R-Mutura/BIM_BOARD/Images/BIM_PCB 1.png

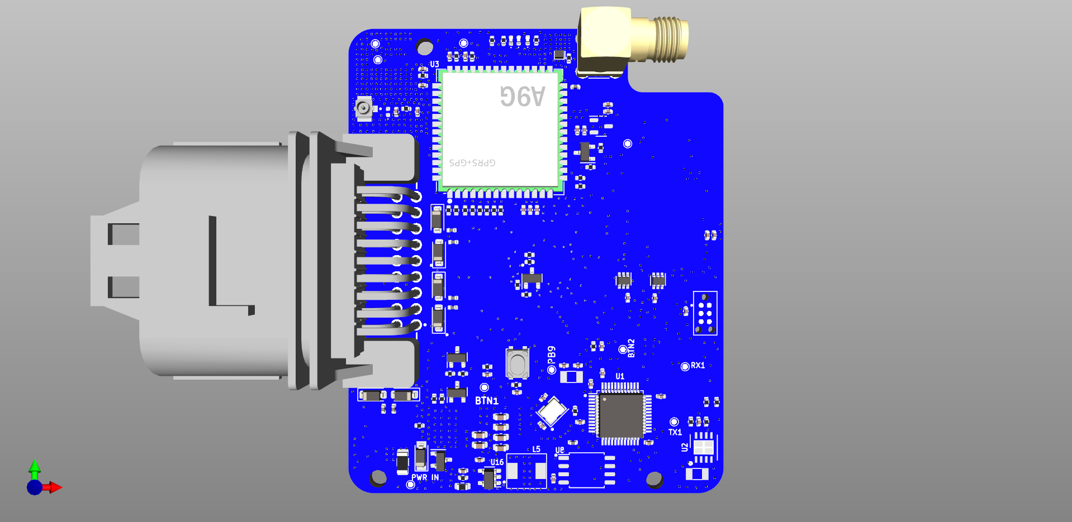
Images/BIM_PCB 1.png
