R-Mutura/BIM_BOARD/Images/BIM_PCB 3.png

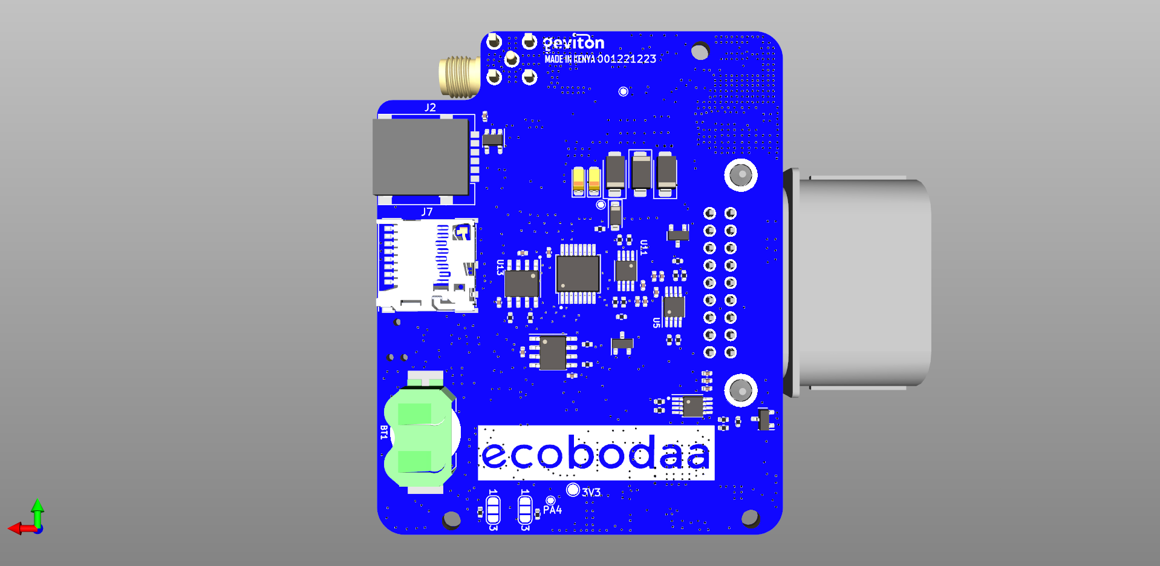
Images/BIM_PCB 3.png
