R-Mutura/BIM_BOARD/ASSETS/BIM_PCB_V2/connector description.txt

COMM:
- A
- B
- GND
- 5V

DISPLAY
- 3V3
- DI
- SCK
- DC
- CS
- RST
- Backlight
- BUZZER
- BUTTON
- GND

PROGRAM
- SWD
- SCK
- SWO
- GND
- RESET
