R-Mutura/BIM_BOARD/ASSETS/BIM_PCB_V2/Connectors.png

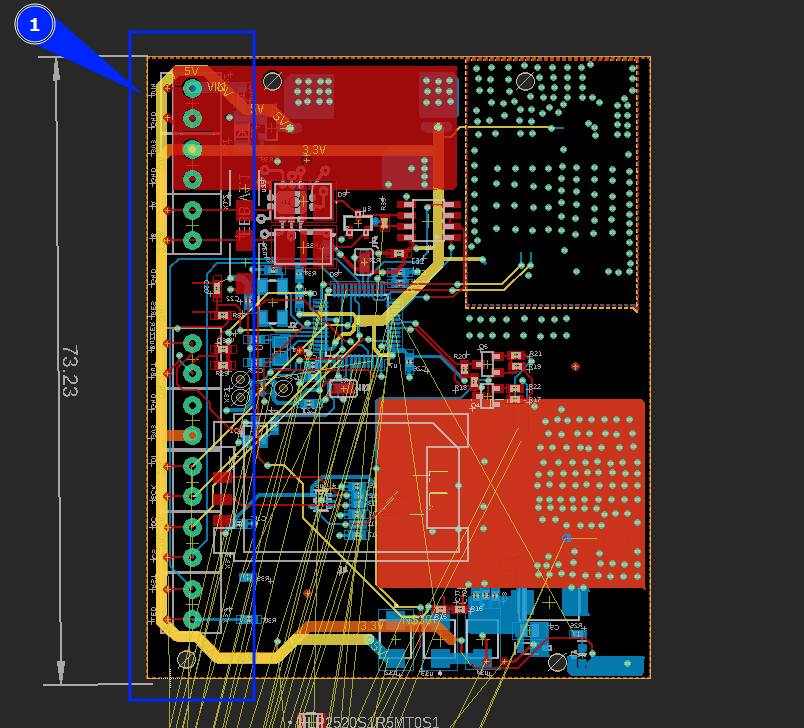
ASSETS/BIM_PCB_V2/Connectors.png
