R-Mutura/BIM_BOARD/Images/BIM_PCB 5.png

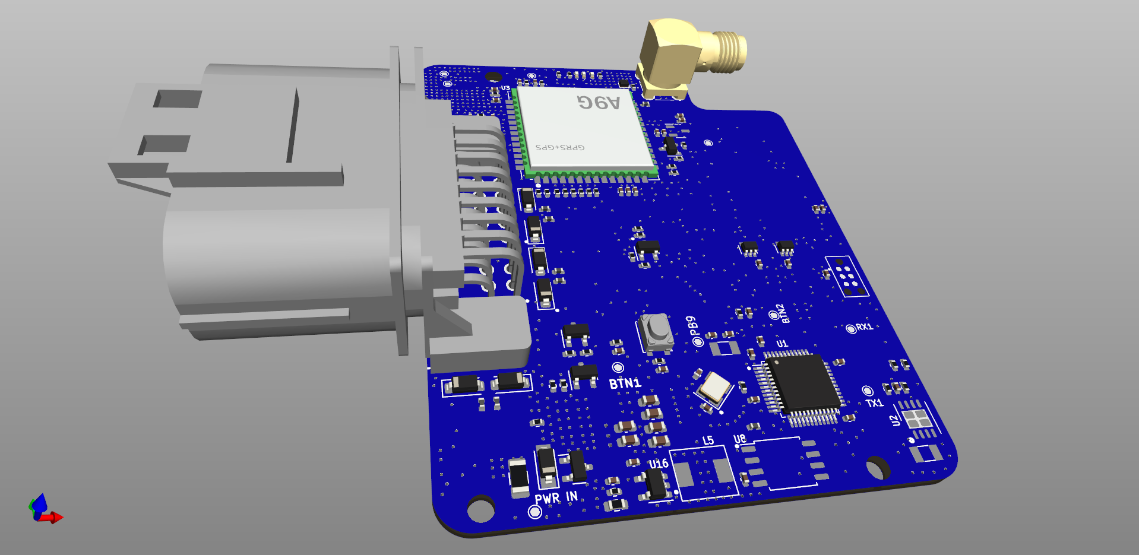
Images/BIM_PCB 5.png
