R-Mutura/BIM_BOARD/ASSETS/BIM_V2.DXF

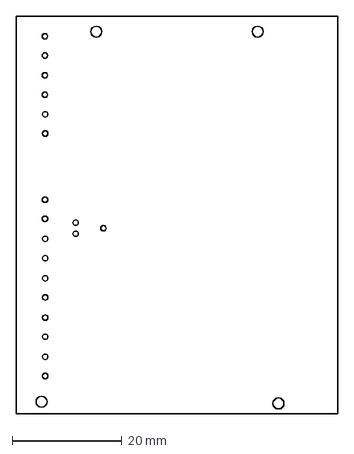
[picture p5: CAD file, 2023-12-07]
ASSETS/BIM_V2.DXF
58.6 x 72.5 mm
