R-Mutura/BIM_BOARD/SCH_PDF/BIM_PCB.pdf

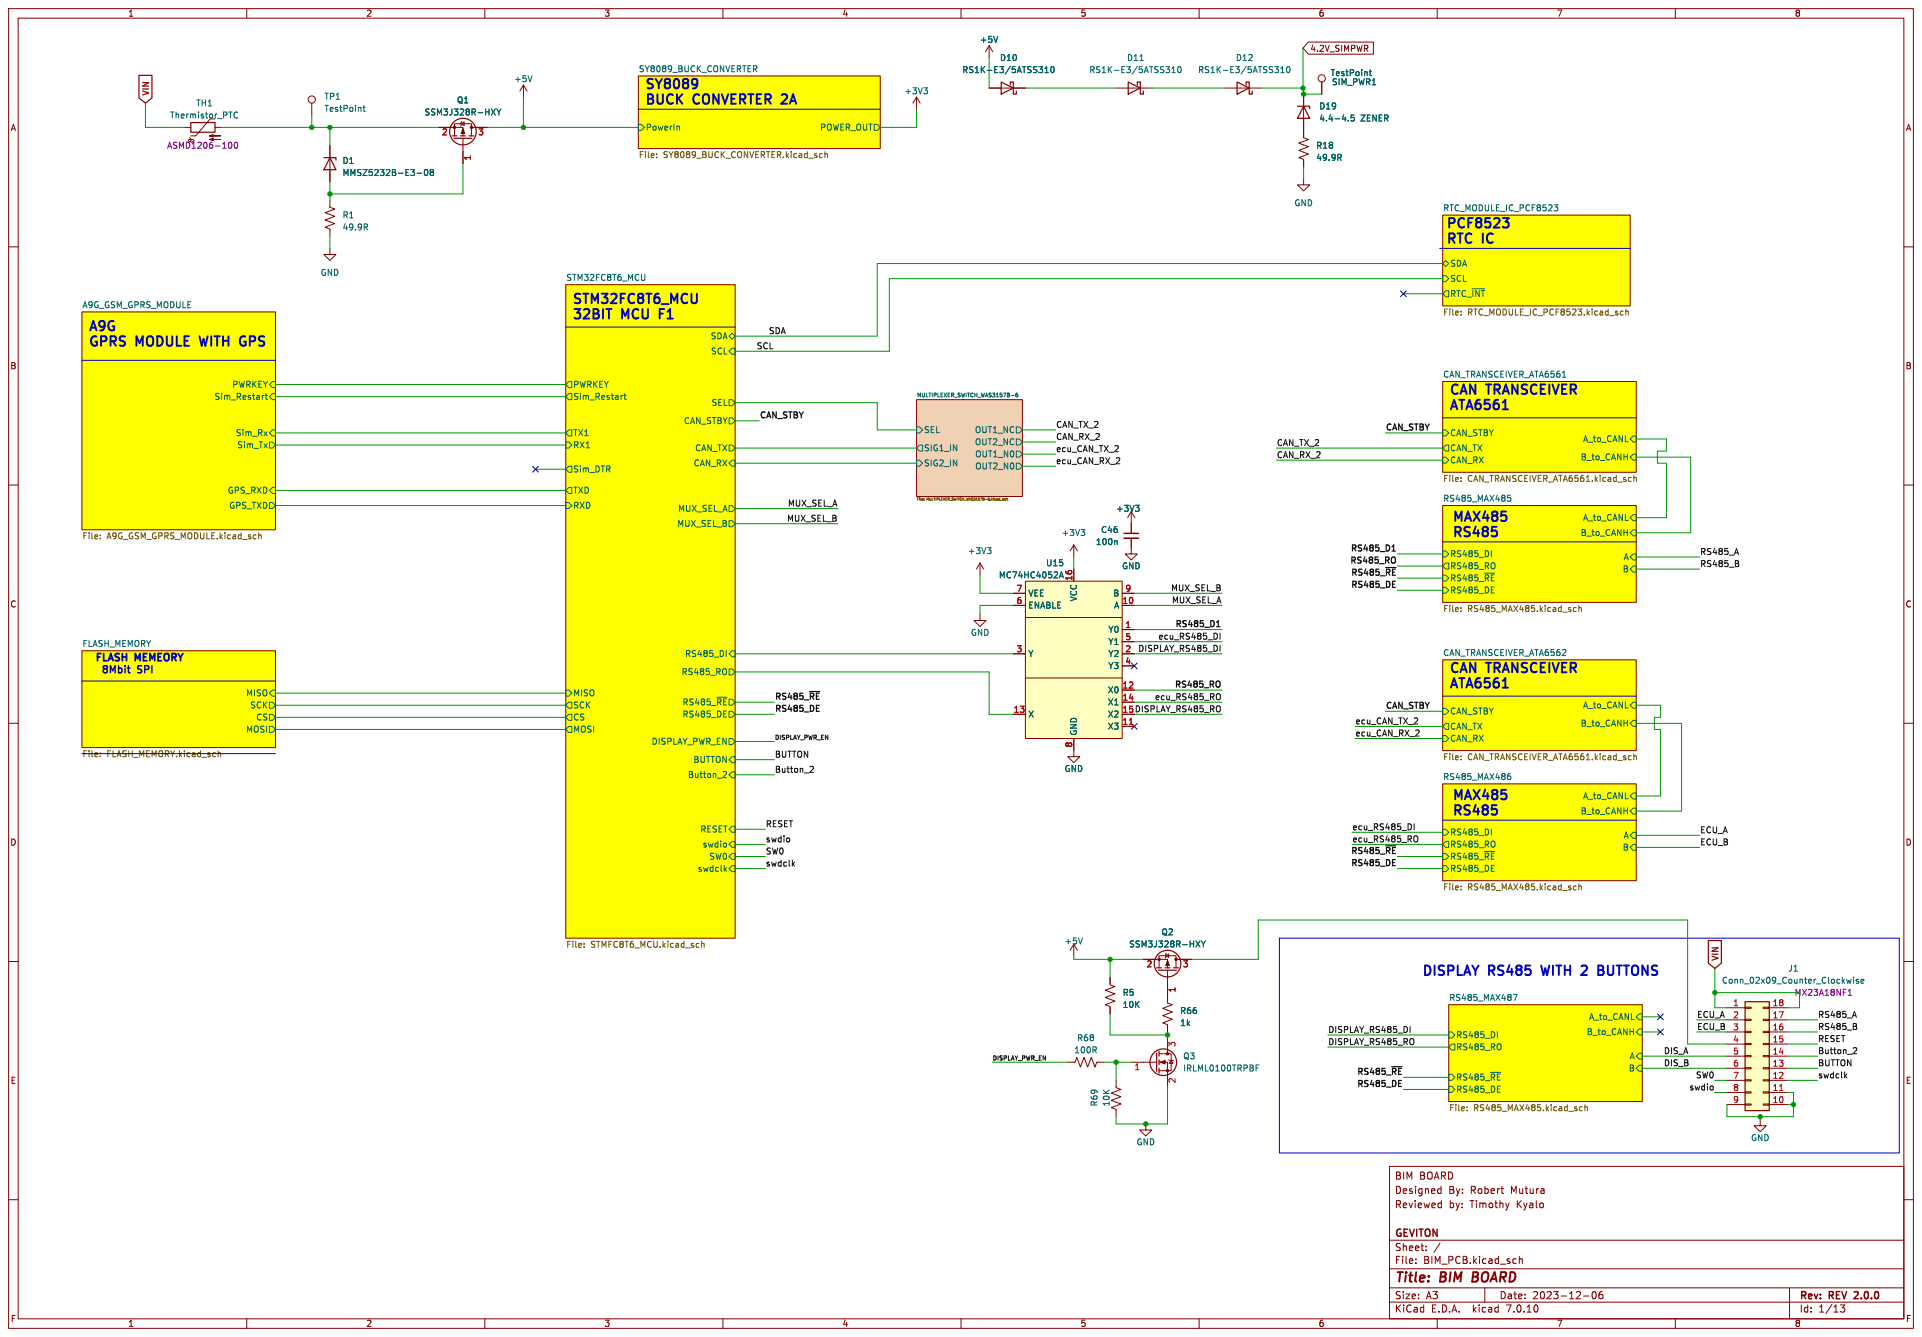
[picture p6: page 1]

Id: 1/13 Title: BIM BOARD

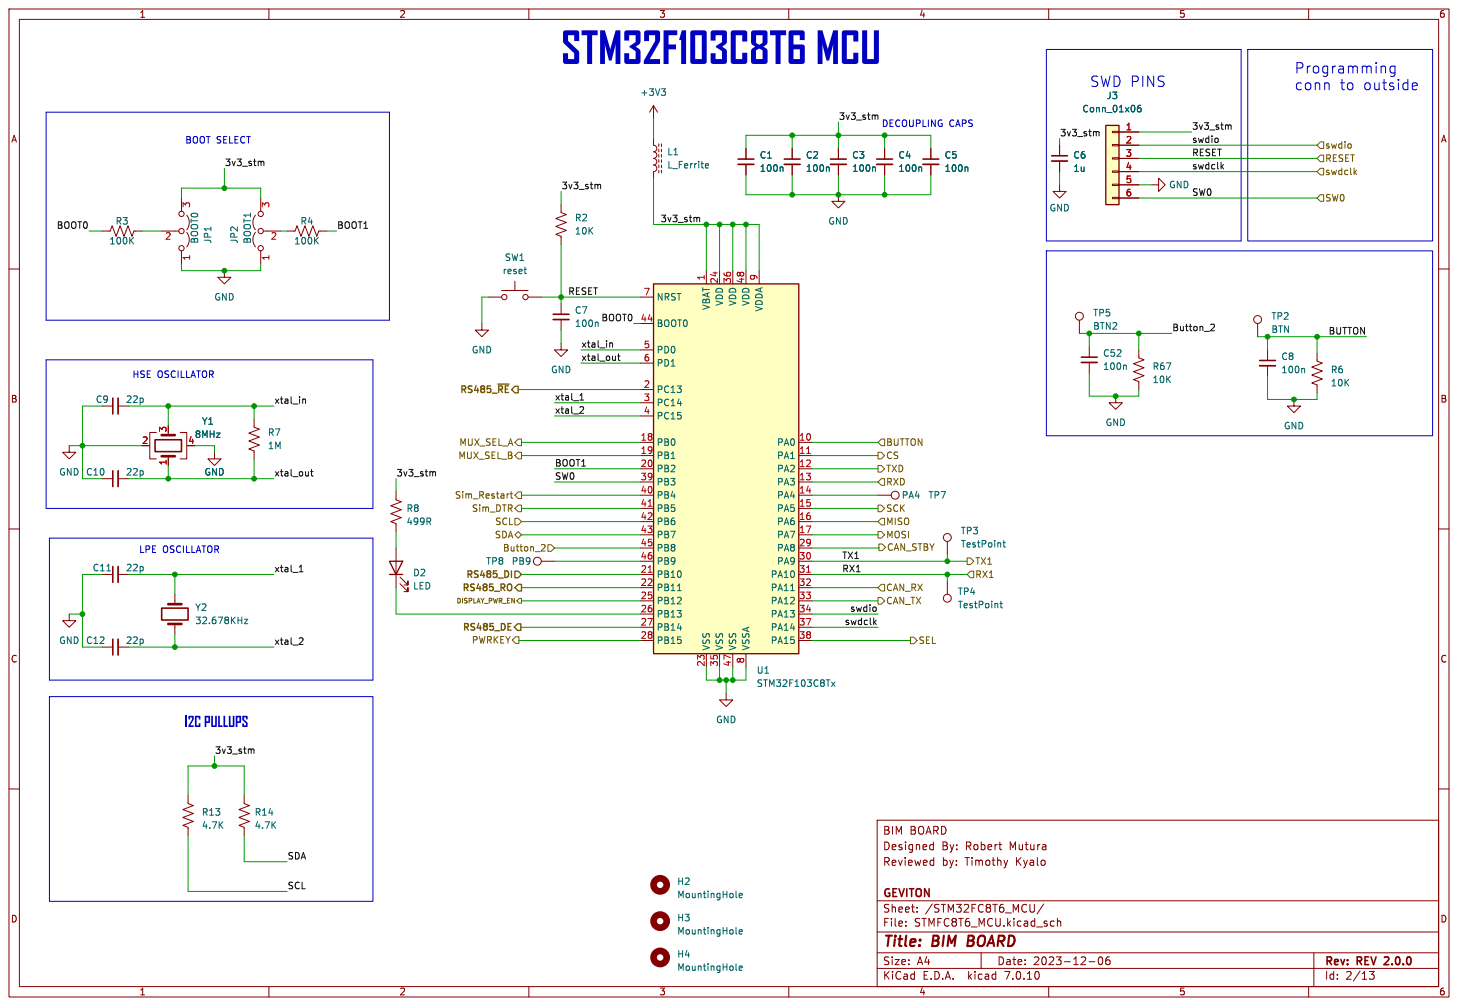
[picture p7: page 2]

DECOUPLING CAPS HSE OSCILLATOR

1 PA0 10 PA1 11 PA2 12 PA3 13 PA4 14 PA5 15 PA6 16 PA7 17 PB0 18 PB1 19 PC13 2 PB2 20 PB10 21 PB11 22 VSS 23 VDD 24 PB12 25 PB13 26 PB14 27 PB15 28 PA8 29 PC14 3 PA9 30 PA10 31 PA11 32 PA12 33 PA13 34 VSS 35 VDD 36 PA14 37 PA15 38 PB3 39 PC15 4 PB4 40 PB5 41 PB6 42 PB7 43 BOOT0 44 PB8 45 PB9 46 VSS 47 VDD 48 PD0 5 PD1 6 NRST 7 VSSA

Id: 2/13 Title: BIM BOARD

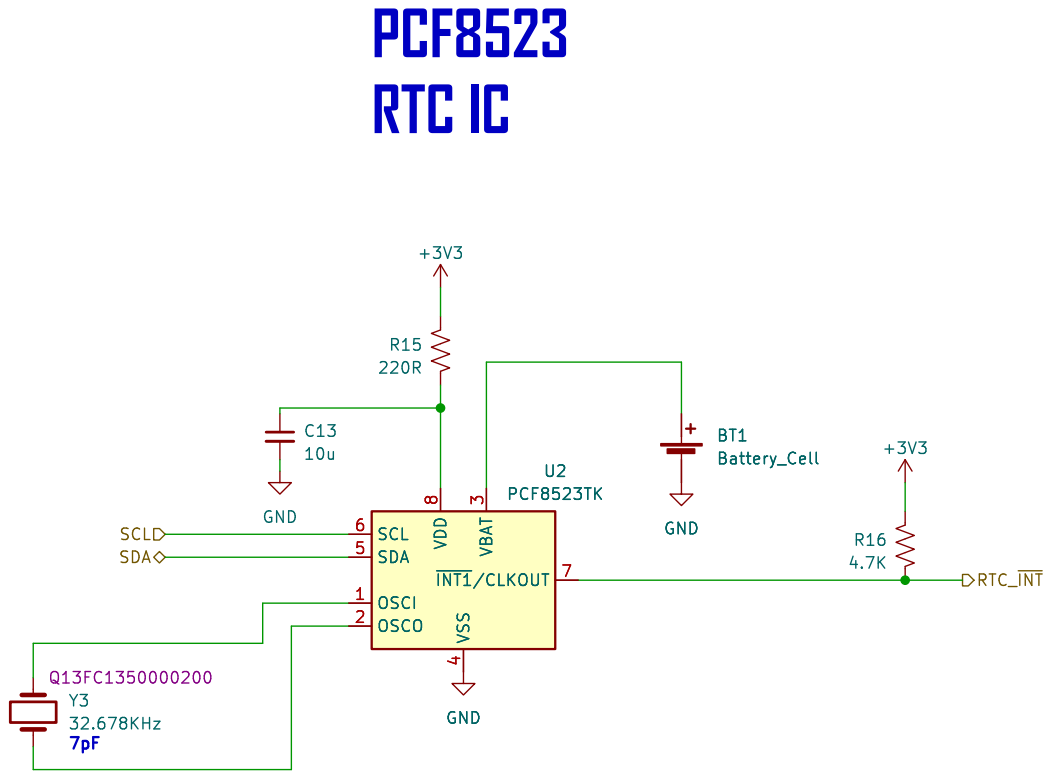
[picture p8: page 3]

Id: 3/13 Title: BIM BOARD

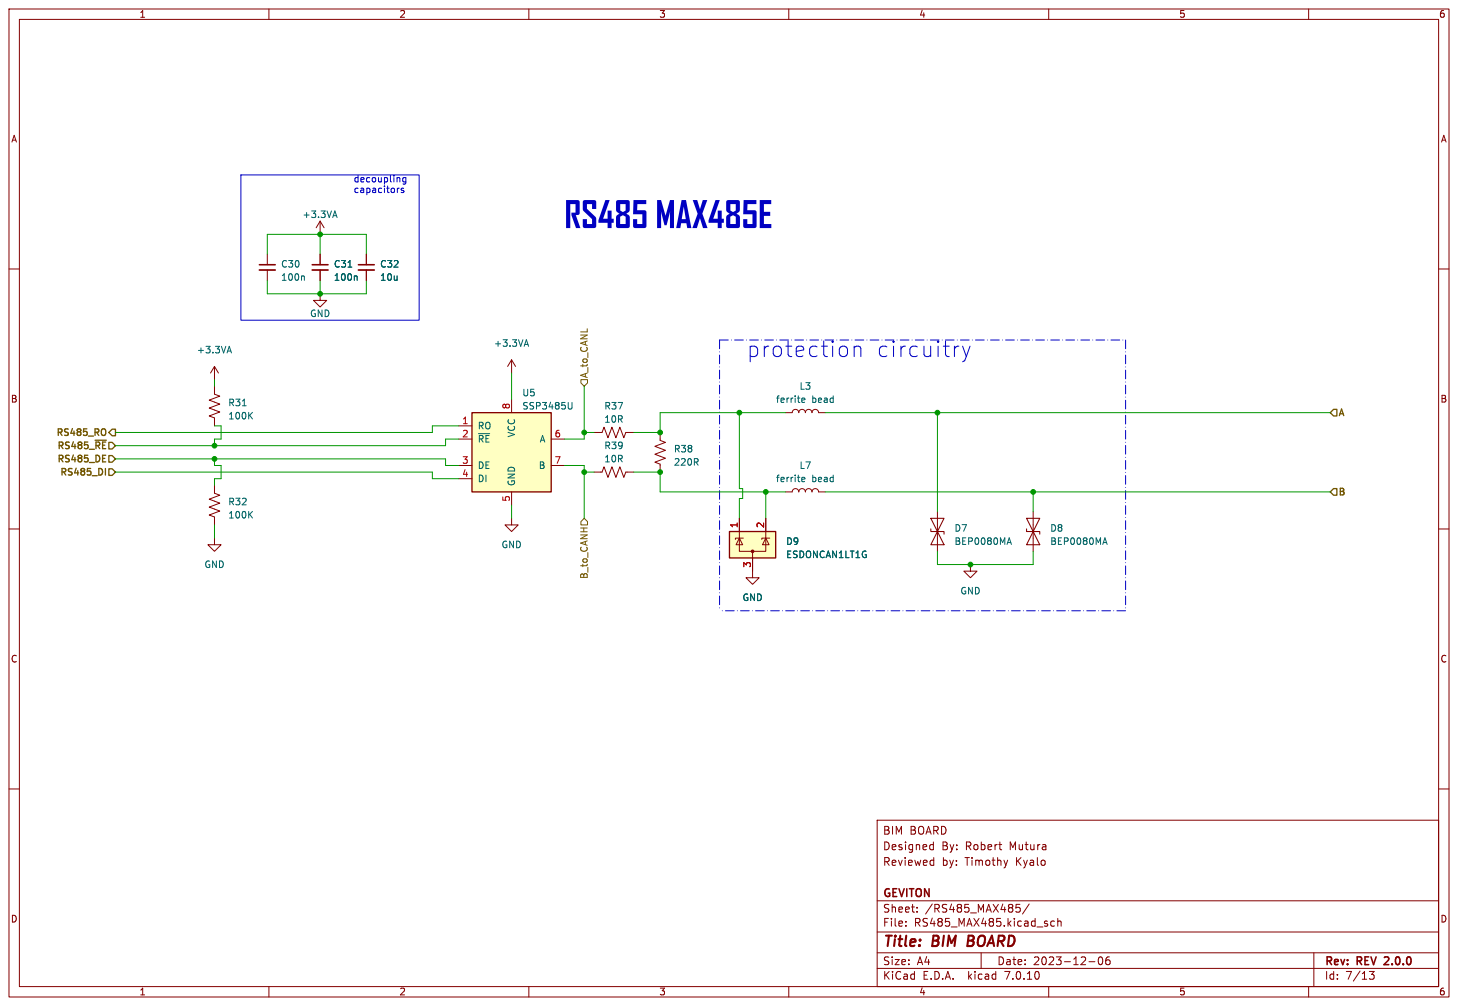
[picture p9: page 4]

Id: 7/13 Title: BIM BOARD

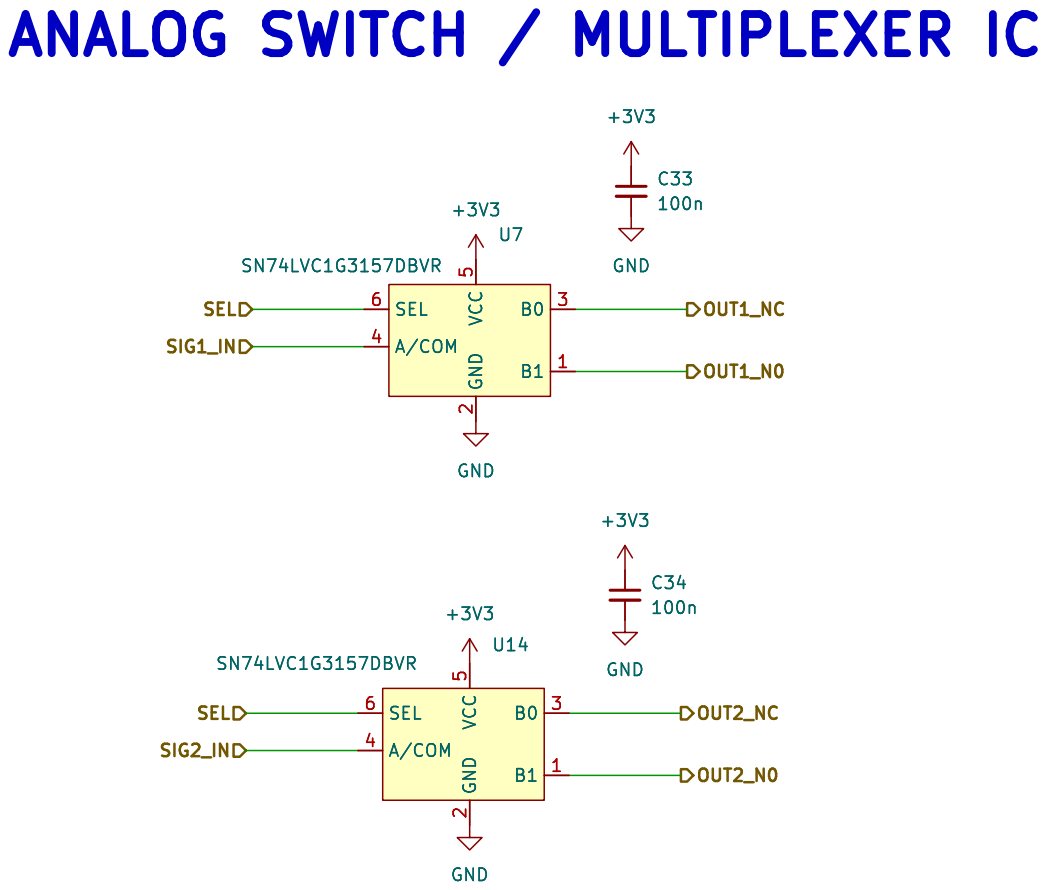
[picture p10: page 5]

Id: 8/13 Title: File: MULTIPLEXER_SWITCH_WAS3157B-6.kicad_sch Sheet: /MULTIPLEXER_SWITCH_WAS3157B-6/ GND

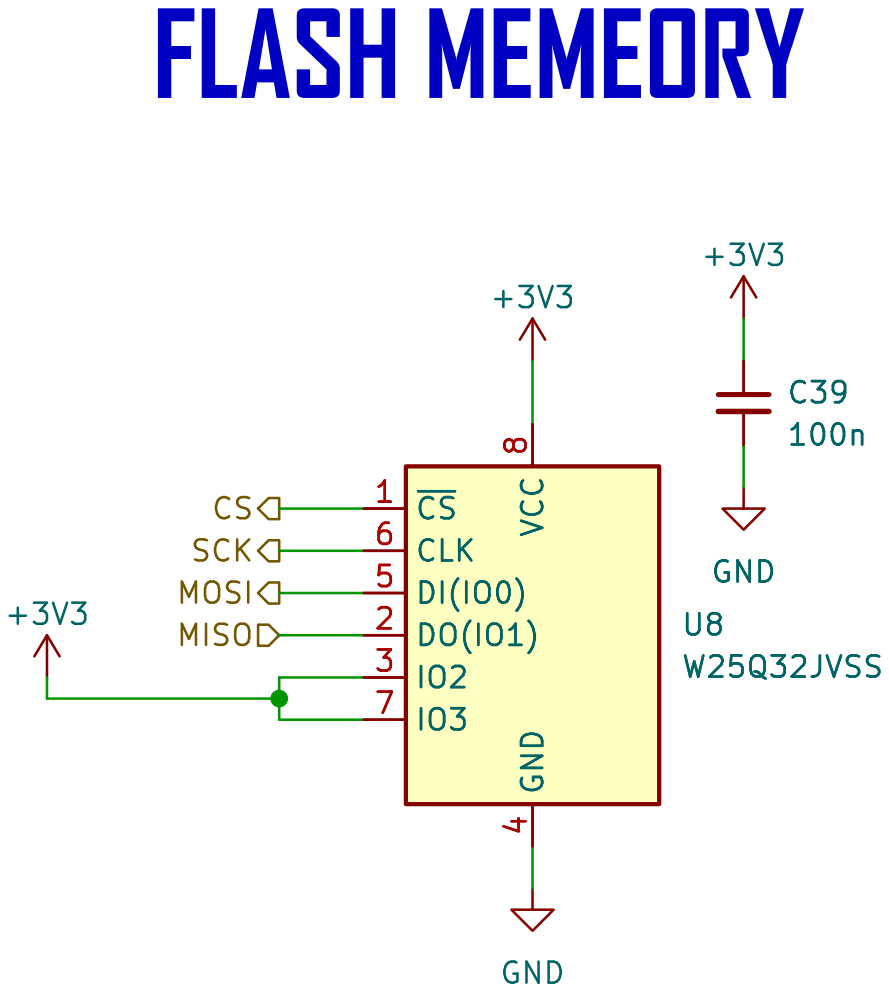
[picture p11: page 6]

SCK MOSI MISO FLASHMEMEORY

Id: 9/13 Title: BIM BOARD

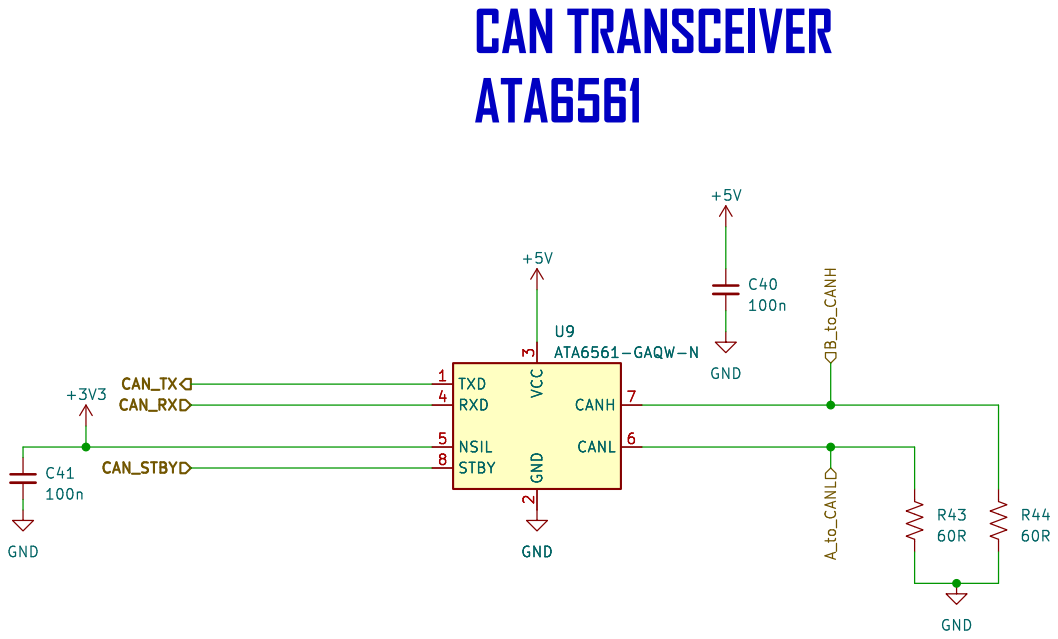
[picture p12: page 7]

3 RXD 4 NSIL 5 CANL 6 CANH 7 STBY 8 U9ATA6561-GAQW-N

3 RXD 4 NSIL 5 CANL 6 CANH 7 STBY 8

Id: 10/13 Title: BIM BOARD

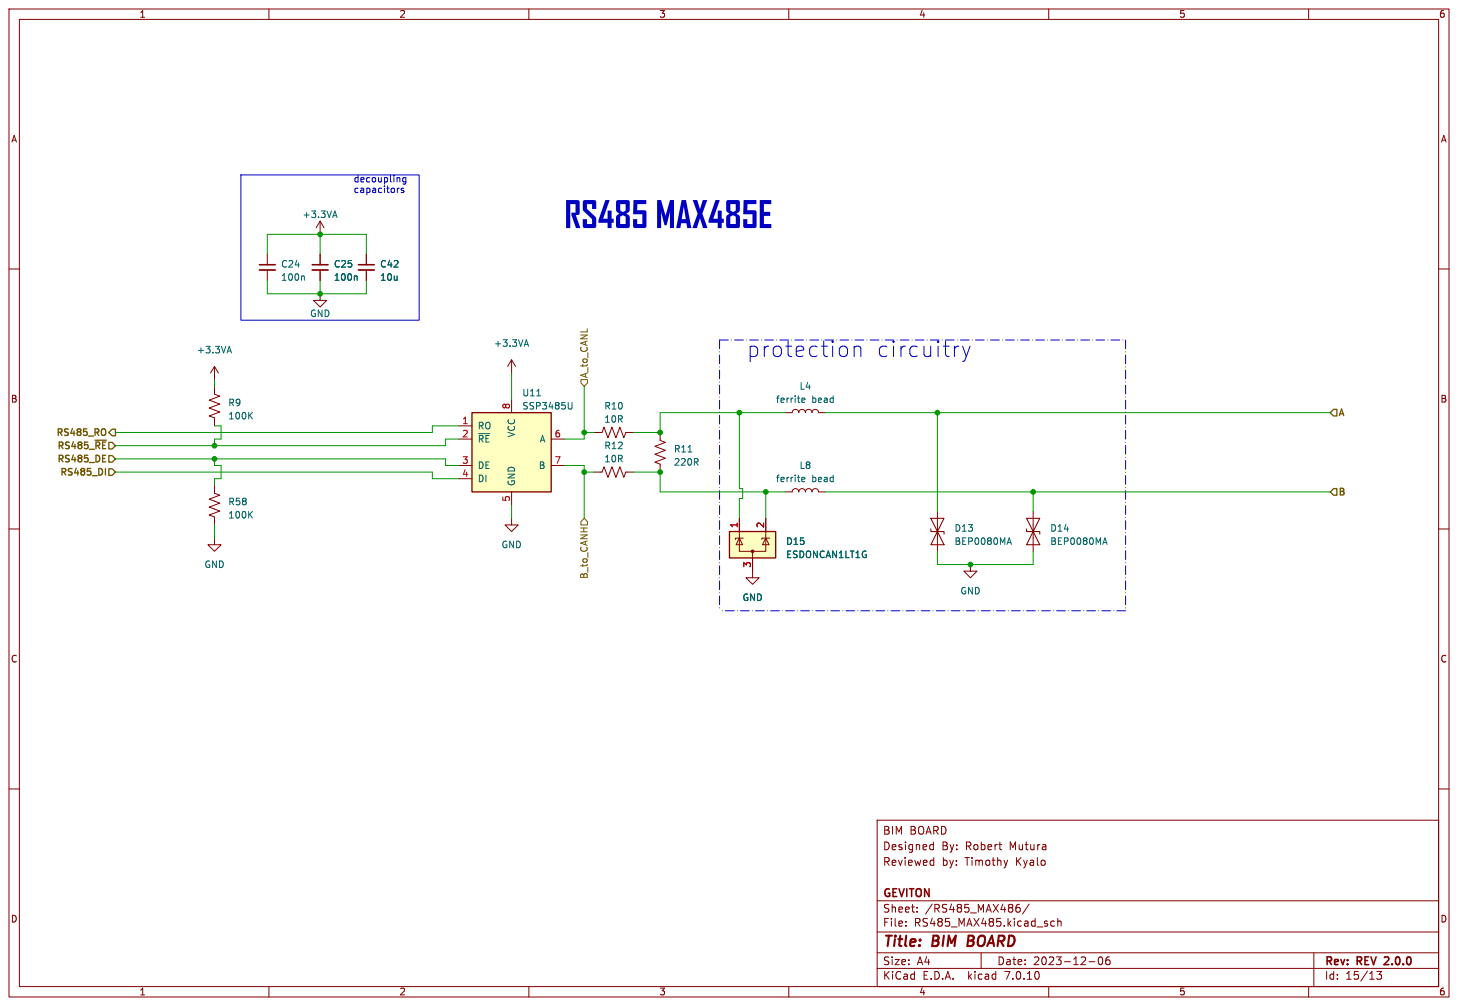
[picture p13: page 8]

Id: 15/13 Title: BIM BOARD

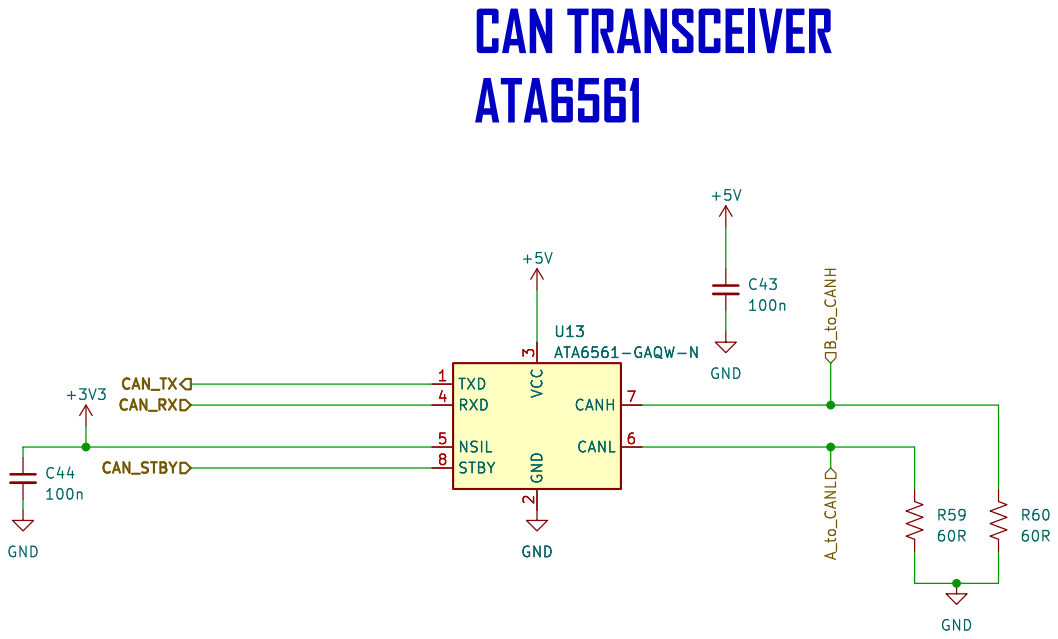
[picture p14: page 9]

3 RXD 4 NSIL 5 CANL 6 CANH 7 STBY 8 U13 ATA6561-GAQW-N GND GND

3 RXD 4 NSIL 5 CANL 6 CANH 7 STBY 8 GND

Id: 16/13 Title: BIM BOARD

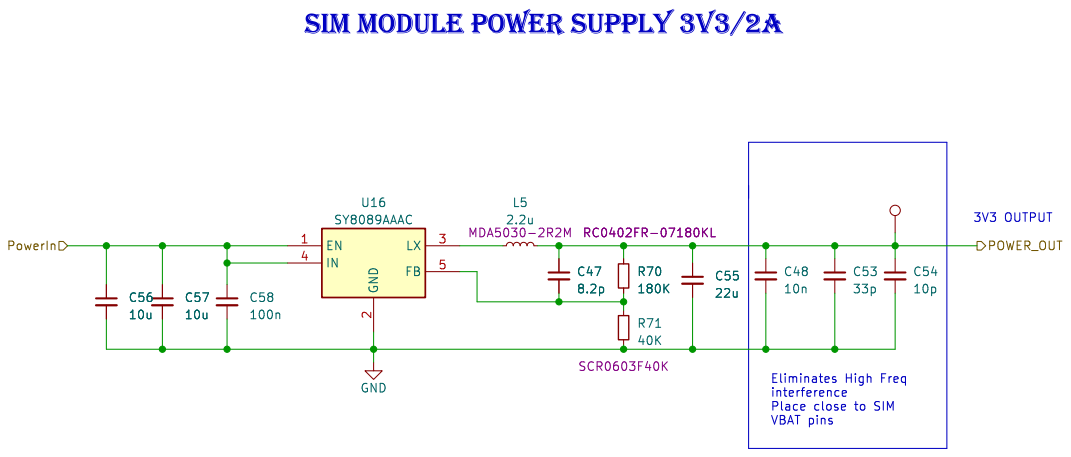
[picture p15: page 10]

Id: 18/13 Title: File: SY8089_BUCK_CONVERTER.kicad_sch Sheet: /SY8089_BUCK_CONVERTER/ GND

interference Place close to SIM

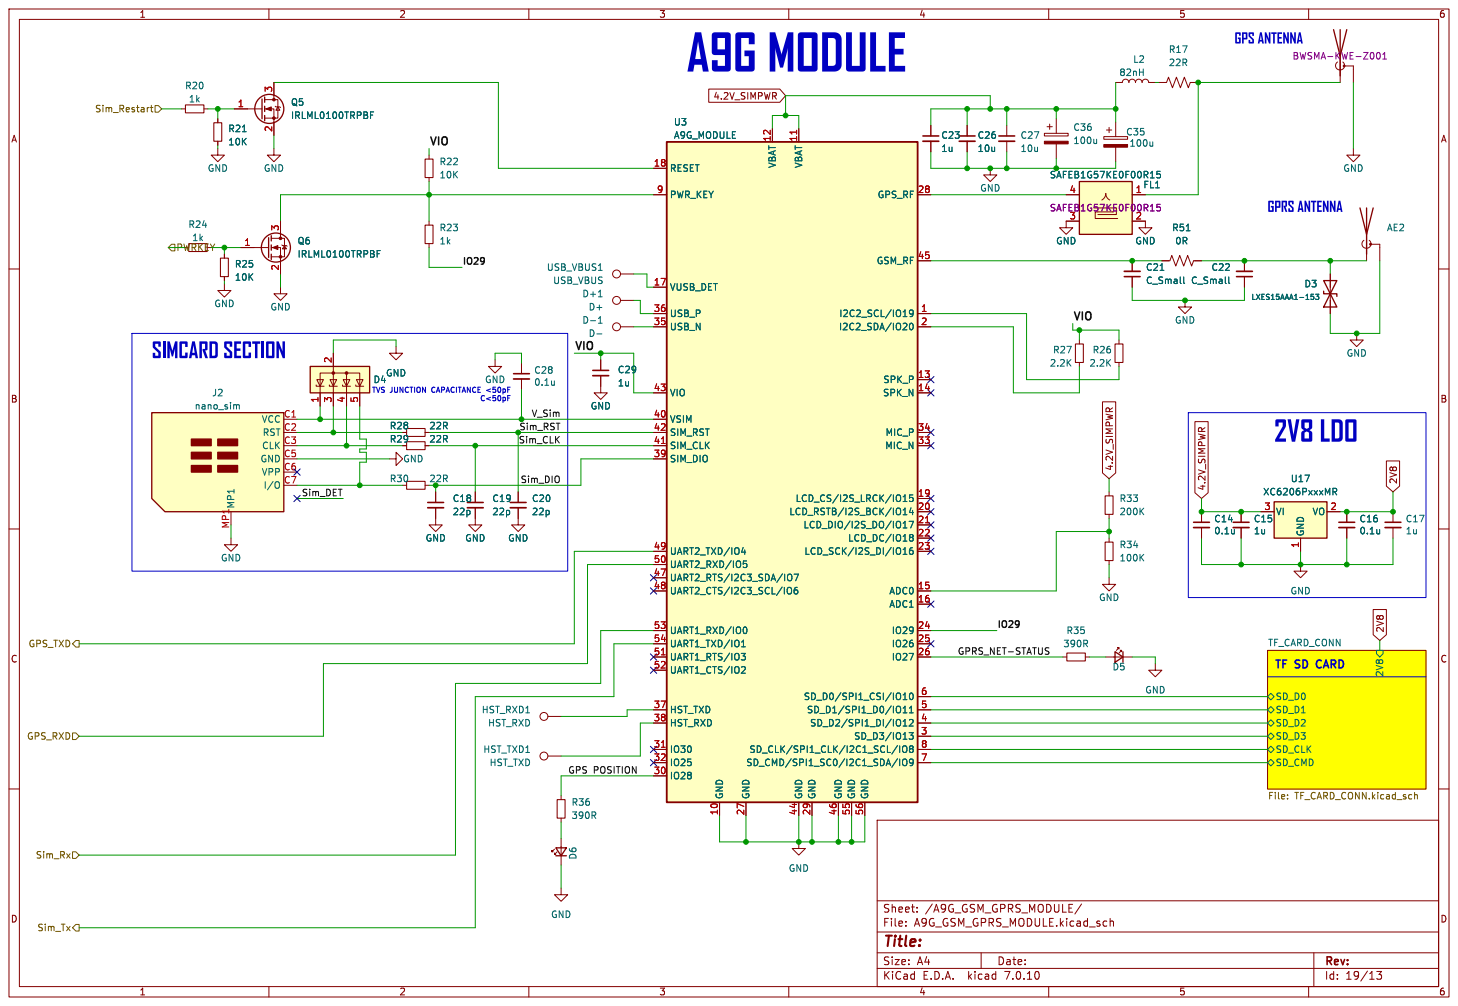
[picture p16: page 11]

LXES15AAA1-153 VCC C1 RST C2 CLK C3 GND C5 VPP C6

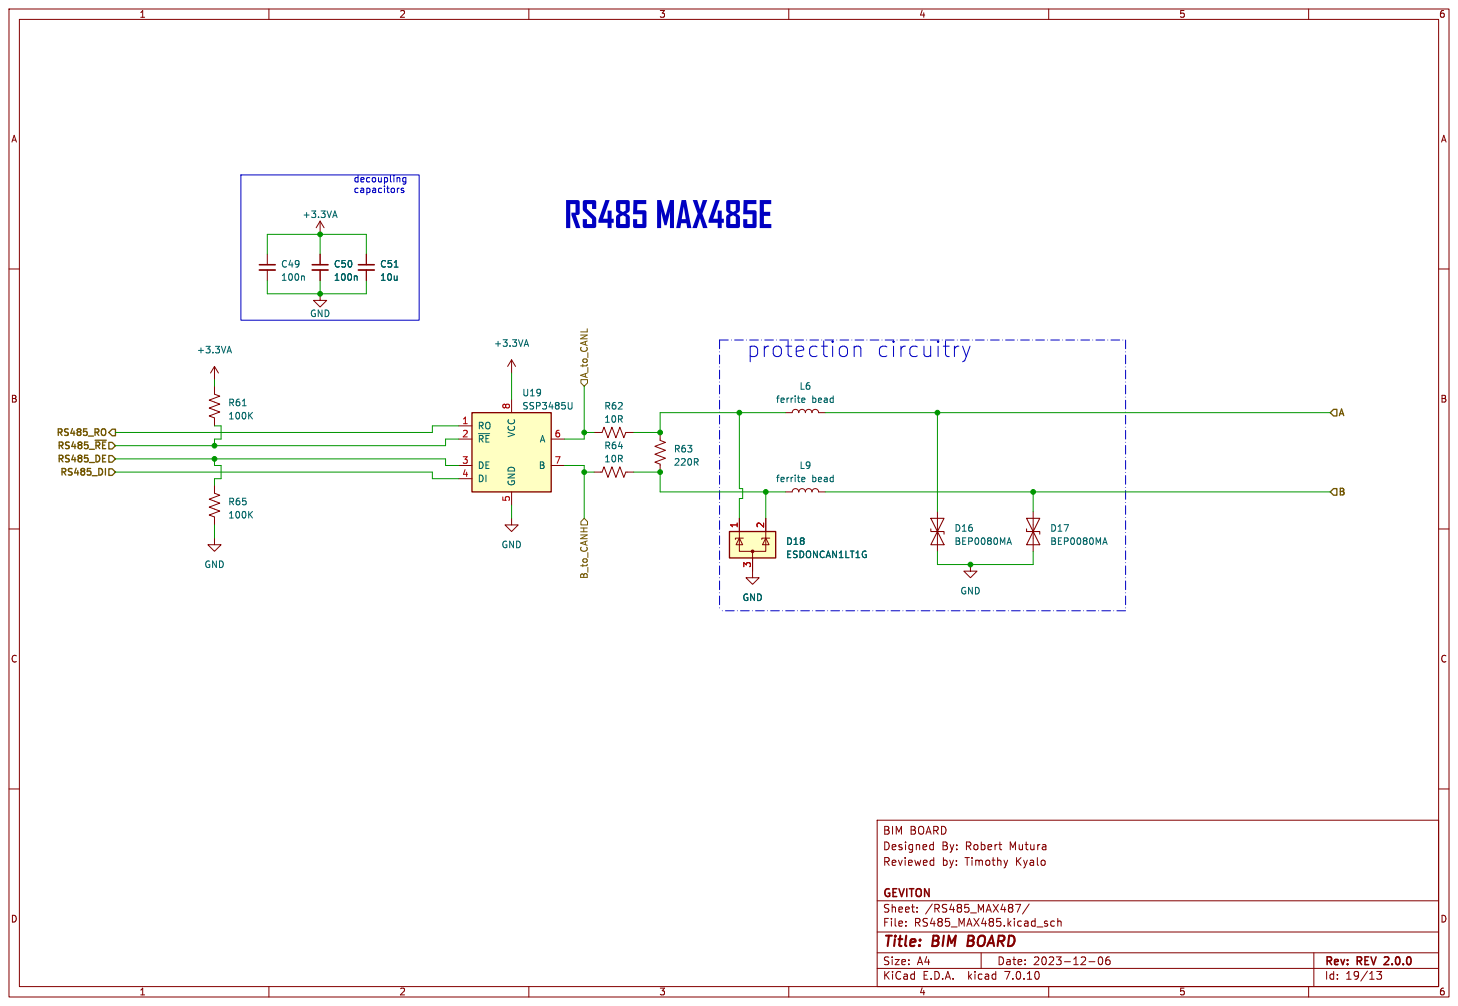
[picture p17: page 12]

Id: 19/13 Title: BIM BOARD

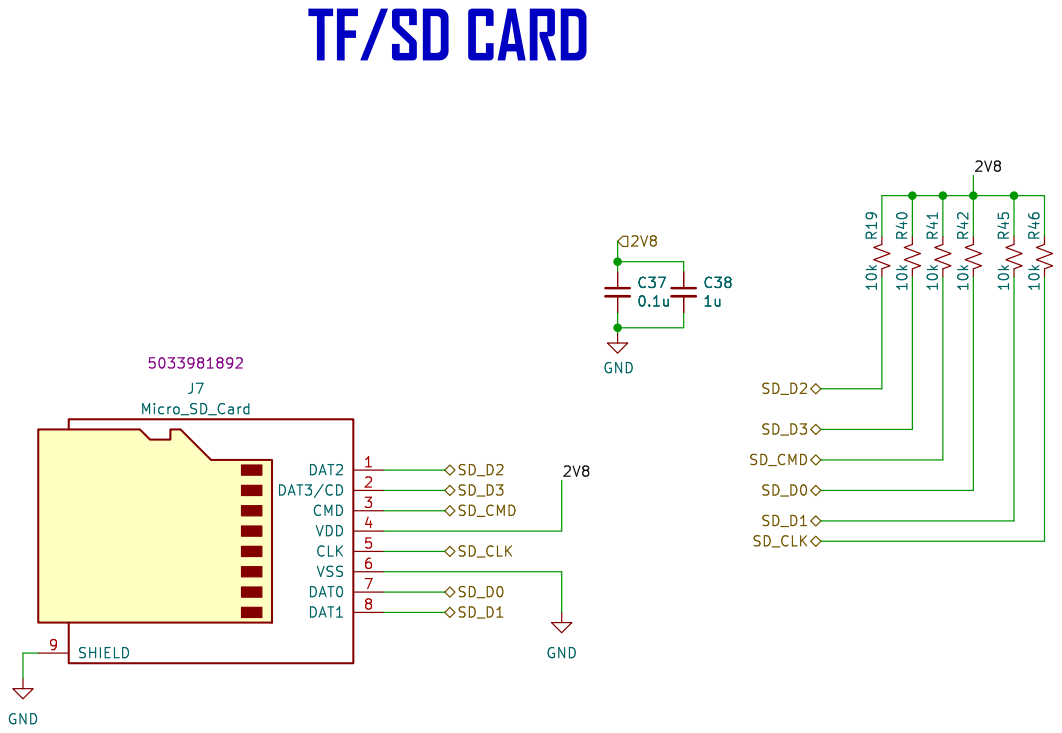
[picture p18: page 13]
