R-Mutura/BIM_BOARD/SCH_PDF/bottom_bim_placement_guide.pdf

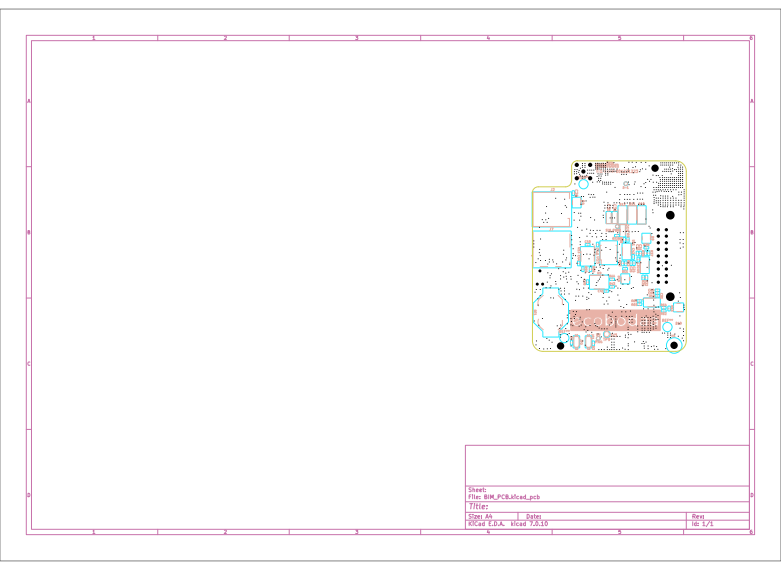
[picture p19: page 1]
