R-Mutura/BIM_BOARD/SCH_PDF/top_bim_placement_guide.pdf

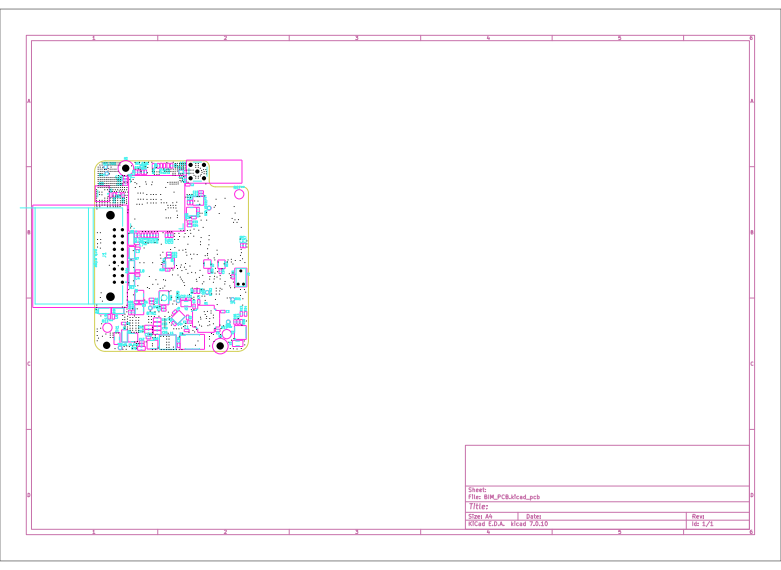
[picture p20: page 1]
