R-Mutura/BIM_BOARD/SOURCE_FILES/BIM_PCB/BIM_PCB.kicad_pcb

## KiCad design SOURCE_FILES/BIM_PCB/BIM_PCB.kicad_pcb (2024-02-07)

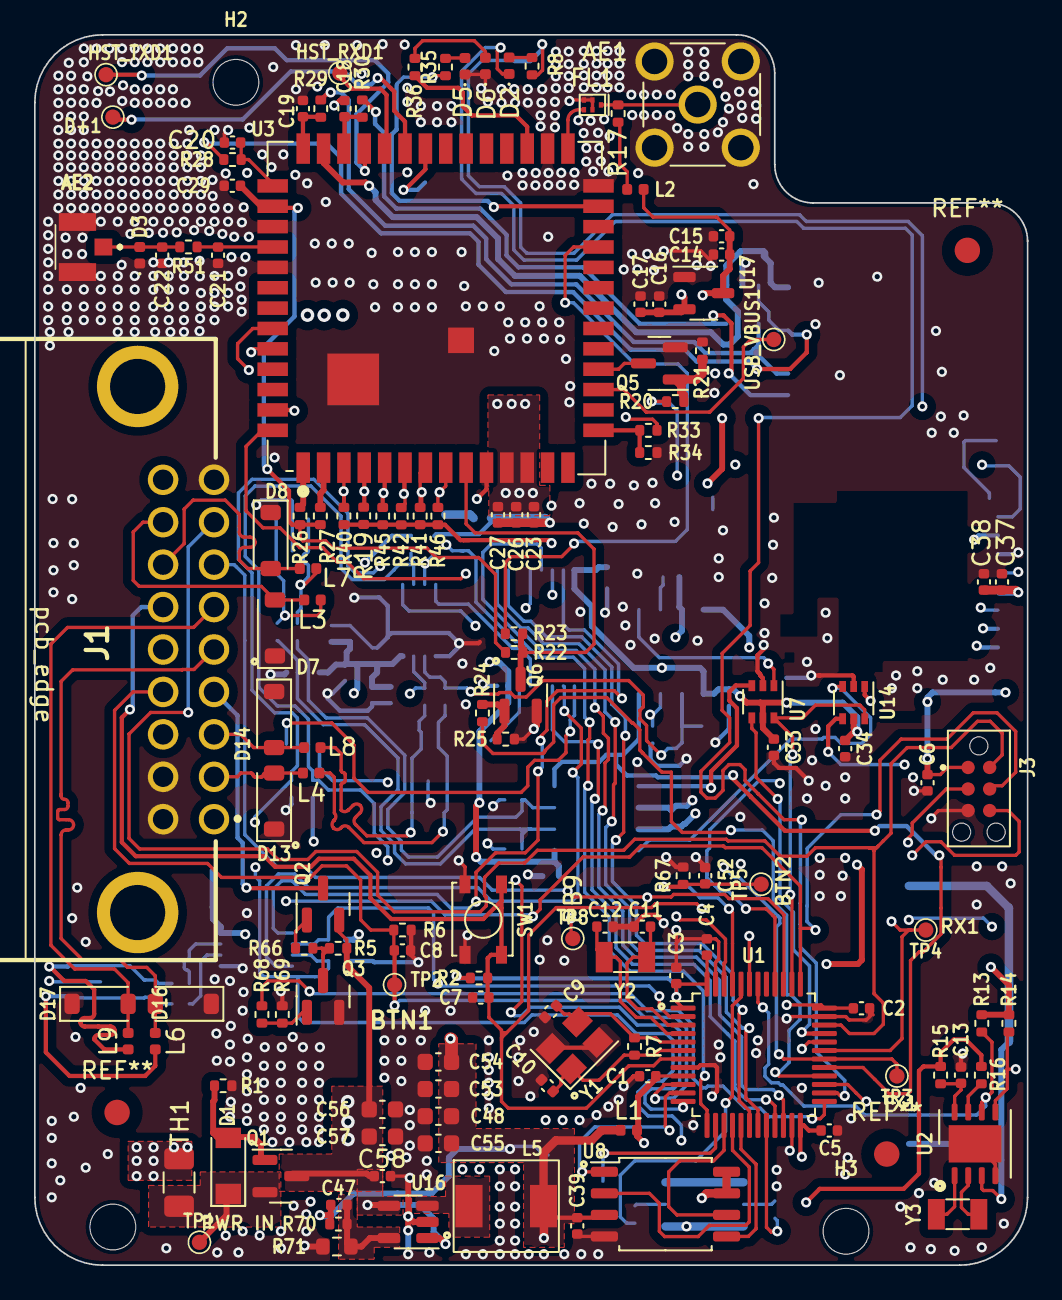
[picture p21: board BIM_PCB.kicad_pcb from above]

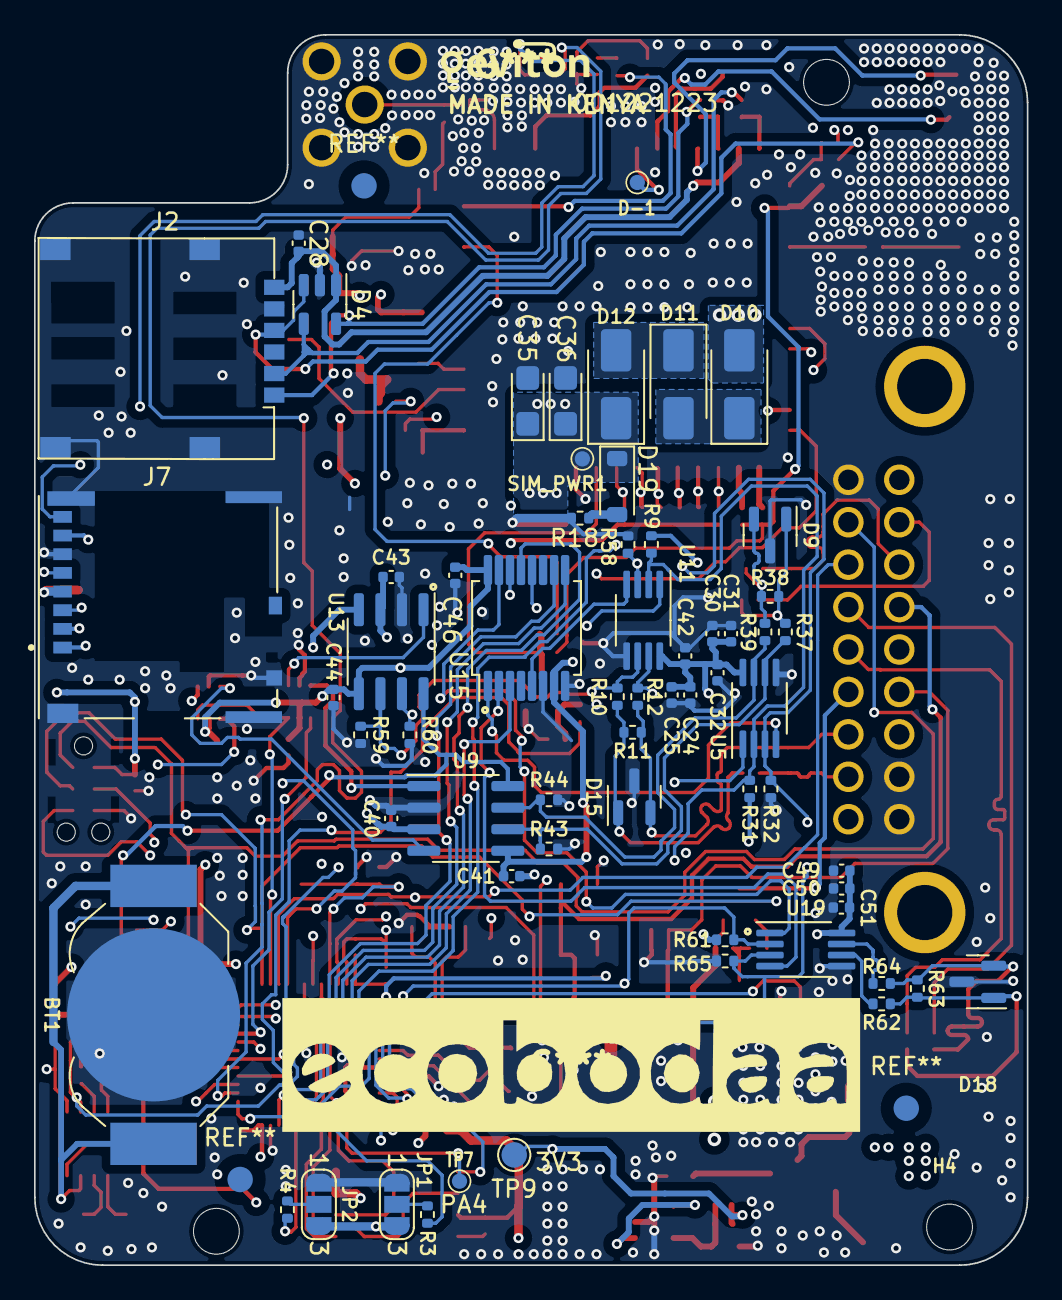
[picture p22: board BIM_PCB.kicad_pcb from below]

Board: 4 copper layers, 58.5 x 72.5 mm, 197 parts (63 on the bottom side), 129 nets.

Parts:
AE1: Antenna_Shield; SMA_Molex_73251-2200_Horizontal
AE2: Antenna_Shield; UFL_COAX_CONN23370191
BT1: Battery_Cell; BatteryHolder_LINX_BAT-HLD-012-SMT
C1, C2, C3, C4, C5, C7, C8, C24, C25, C30, C31, C33, C34, C39, C40, C41, C43, C44, C46, C49, C50, C52, C58: 100n; C_0402_1005Metric
C6, C15, C17, C23, C29, C38: 1u; C_0402_1005Metric
C9, C10, C11, C12, C18, C19, C20: 22p; C_0402_1005Metric
C13, C26, C27, C32, C42, C51: 10u; C_0402_1005Metric
C14, C16, C28, C37: 0.1u; C_0402_1005Metric
C21, C22: C_Small; C_0402_1005Metric
C35, C36: 100u; CP_EIA-3216-18_Kemet-A
C47: 8.2p; C_0402_1005Metric
C48: 10n; C_0603_1608Metric
C53: 33p; C_0603_1608Metric
C54: 10p; C_0603_1608Metric
C55: 22u; C_0603_1608Metric
C56, C57: 10u; C_0603_1608Metric
D1: MMSZ5232B-E3-08; D_SOD-123
D2: LED; LED_0402_1005Metric
D3: LXES15AAA1-153; D_0402_1005Metric
D4: SP0504BAHT; SOT-23-5
D5: ORANGE; LED_0402_1005Metric
D6: BLUE; LED_0402_1005Metric
D7, D8, D13, D14, D16, D17: BEP0080MA; D_SOD-123
D9, D15, D18: ESDONCAN1LT1G; SOT-23
D10: RS1K-E3/5ATSS310; D_SMA
D11, D12: SS310; D_SMA
D19: 4.4-4.5 ZENER; D_SOD-123
D+1: D+; TestPoint_Pad_D0.9mm
D-1: D-; TestPoint_Pad_D0.9mm
FL1: SAFEB1G57KE0F00R15; Filter_1411-5_1.4x1.1mm
H2, H3, H4: MountingHole; MountingHole_2.7mm
HST_RXD1: HST_RXD; TestPoint_Pad_D0.9mm
HST_TXD1: HST_TXD; TestPoint_Pad_D0.9mm
J1: Conn_02x09_Counter_Clockwise; conn_18pin_02x09_angled_MX23A18NF1
J2: nano_sim; nano_sim_NSIM-2-C
J3: Conn_01x06; J-LINK_6-PIN_NEEDLE_ADAPTER
J7: Micro_SD_Card; MOLEX_503398-1892
JP1: BOOT0; SolderJumper-3_P1.3mm_Open_RoundedPad1.0x1.5mm_NumberLabels
JP2: BOOT1; SolderJumper-3_P1.3mm_Open_RoundedPad1.0x1.5mm_NumberLabels
L1: L_Ferrite; L_0402_1005Metric
L2: 82nH; L_0402_1005Metric
L3, L4, L6, L7, L8, L9: ferrite bead; L_0402_1005Metric
L5: 2.2u; MDA5030-100M
Q1, Q2: SSM3J328R-HXY; SOT-23
Q3, Q5, Q6: IRLML0100TRPBF; SOT-23
R1, R18: 49.9R; R_0402_1005Metric
R2, R5, R6, R21, R22, R25, R67, R69: 10K; R_0402_1005Metric
R3, R4, R9, R31, R32, R34, R58, R61, R65: 100K; R_0402_1005Metric
R7: 1M; R_0402_1005Metric
R8: 499R; R_0402_1005Metric
R10, R12, R37, R39, R62, R64: 10R; R_0402_1005Metric
R11, R15, R38, R63: 220R; R_0402_1005Metric
R13, R14, R16: 4.7K; R_0402_1005Metric
R17, R28, R29, R30: 22R; R_0402_1005Metric
R19, R40, R41, R42, R45, R46: 10k; R_0402_1005Metric
R20, R23, R24, R66: 1k; R_0402_1005Metric
R26, R27: 2.2K; R_0402_1005Metric
R33: 200K; R_0402_1005Metric
R35, R36: 390R; R_0402_1005Metric
R43, R44, R59, R60: 60R; R_0402_1005Metric
R51: 0R; R_0402_1005Metric
R68: 100R; R_0402_1005Metric
R70: 180K; R_0402_1005Metric
R71: 40K; R_0603_1608Metric
SIM_PWR1: TestPoint; TestPoint_Pad_D0.9mm
SW1: reset; SKRPACE010
TH1: Thermistor_PTC; Fuse_1206_3216Metric
TP1, TP3, TP4: TestPoint; TestPoint_Pad_D0.9mm
TP2: BTN; TestPoint_Pad_D0.9mm
TP5: BTN2; TestPoint_Pad_D0.9mm
TP7: PA4; TestPoint_Pad_D0.9mm
TP8: PB9; TestPoint_Pad_D0.9mm
TP9: TestPoint; TestPoint_Pad_D1.5mm
U1: STM32F103C8Tx; LQFP-48_7x7mm_P0.5mm
U2: PCF8523TK; HVSON-8-1EP_4x4mm_P0.8mm_EP2.2x3.1mm
U3: A9G_MODULE
U5, U11, U19: SSP3485U; MSOP-8_3x3mm_P0.65mm
U7, U14: SN74LVC1G3157DBVR; SOT-363_SC-70-6
U8: W25Q32JVSS; SOIC-8_5.23x5.23mm_P1.27mm
U9, U13: ATA6561-GAQW-N; SOIC-8_3.9x4.9mm_P1.27mm
U15: MC74HC4052A; SSOP-16_5.3x6.2mm_P0.65mm
U16: SY8089AAAC; SOT-23-5
U17: XC6206PxxxMR; SOT-23-3
USB_VBUS1: USB_VBUS; TestPoint_Pad_D0.9mm
Y1: 8MHz; Crystal_SMD_3225-4Pin_3.2x2.5mm
Y2, Y3: 32.678KHz; Crystal_SMD_3215-2Pin_3.2x1.5mm

Connections:
2V8: C16.1, C17.1, C37.1, C38.1, J7.4 (VDD), R19.1, R40.1, R41.1, R42.1, R45.1, R46.1, U17.2 (VO)
4.2V_SIMPWR: C14.1, C15.1, C23.1, C26.1, C27.1, C35.1, C36.1, D12.1 (K), D19.1 (K), L2.2, R33.2, SIM_PWR1.1, U3.11 (VBAT), U3.12 (VBAT), U17.3 (VI)
+3.3VA: C24.1, C25.1, C30.1, C31.1, C32.1, C42.1, C49.1, C50.1, C51.1, R9.2, R31.2, R61.2, U5.8 (VCC), U11.8 (VCC), U19.8 (VCC)
+3V3: C33.1, C34.1, C39.1, C41.1, C44.1, C46.1, C47.1, C48.1, C53.1, C54.1, C55.1, L1.1, L5.2, R15.2, R16.2, R70.1, TP9.1, U7.5 (VCC), U8.3 (IO2), U8.7 (IO3), U8.8 (VCC), U9.5 (NSIL), U13.5 (NSIL), U14.5 (VCC), U15.7 (VEE), U15.16 (VCC)
+5V: C40.1, C43.1, C56.1, C57.1, C58.1, D10.2 (A), Q1.3 (D), Q2.2 (S), R5.1, U9.3 (VCC), U13.3 (VCC), U16.1 (EN), U16.4 (IN)
/A9G_GSM_GPRS_MODULE/GPRS_NET-STATUS: R35.1, U3.26 (IO27)
/A9G_GSM_GPRS_MODULE/GPS POSITION: R36.1, U3.30 (IO28)
/A9G_GSM_GPRS_MODULE/GPS_RXD: U1.12 (PA2), U3.50 (UART2_RXD/IO5)
/A9G_GSM_GPRS_MODULE/GPS_TXD: U1.13 (PA3), U3.49 (UART2_TXD/IO4)
/A9G_GSM_GPRS_MODULE/IO29: R23.1, U3.24 (IO29)
/A9G_GSM_GPRS_MODULE/PWRKEY: R24.1, U1.28 (PB15)
/A9G_GSM_GPRS_MODULE/Sim_CLK: C19.1, R29.1, U3.41 (SIM_CLK)
/A9G_GSM_GPRS_MODULE/Sim_DIO: C18.1, R30.1, U3.39 (SIM_DIO)
/A9G_GSM_GPRS_MODULE/Sim_RST: C20.1, R28.1, U3.42 (SIM_RST)
/A9G_GSM_GPRS_MODULE/Sim_Restart: R20.1, U1.40 (PB4)
/A9G_GSM_GPRS_MODULE/TF_CARD_CONN/SD_CLK: J7.5 (CLK), R46.2, U3.8 (SD_CLK/SPI1_CLK/I2C1_SCL/IO8)
/A9G_GSM_GPRS_MODULE/TF_CARD_CONN/SD_CMD: J7.3 (CMD), R41.2, U3.7 (SD_CMD/SPI1_SC0/I2C1_SDA/IO9)
/A9G_GSM_GPRS_MODULE/TF_CARD_CONN/SD_D0: J7.7 (DAT0), R42.2, U3.6 (SD_D0/SPI1_CSI/IO10)
/A9G_GSM_GPRS_MODULE/TF_CARD_CONN/SD_D1: J7.8 (DAT1), R45.2, U3.5 (SD_D1/SPI1_D0/IO11)
/A9G_GSM_GPRS_MODULE/TF_CARD_CONN/SD_D2: J7.1 (DAT2), R19.2, U3.4 (SD_D2/SPI1_DI/IO12)
/A9G_GSM_GPRS_MODULE/TF_CARD_CONN/SD_D3: J7.2 (DAT3/CD), R40.2, U3.3 (SD_D3/IO13)
/A9G_GSM_GPRS_MODULE/VIO: C29.1, R22.2, R26.2, R27.2, U3.43 (VIO)
/A9G_GSM_GPRS_MODULE/V_Sim: C28.2, D4.1 (K), J2.C1 (VCC), U3.40 (VSIM)
/BUTTON: C8.1, J1.13, R6.1, TP2.1, U1.10 (PA0)
/Button_2: C52.1, J1.14, R67.1, TP5.1, U1.45 (PB8)
/CAN_RX_2: U9.4 (RXD), U14.3 (B0)
/CAN_STBY: U1.29 (PA8), U9.8 (STBY), U13.8 (STBY)
/CAN_TRANSCEIVER_ATA6561/A_to_CANL: R37.1, R43.1, U5.6 (A), U9.6 (CANL)
/CAN_TRANSCEIVER_ATA6561/B_to_CANH: R39.1, R44.1, U5.7 (B), U9.7 (CANH)
/CAN_TRANSCEIVER_ATA6562/A_to_CANL: R10.1, R59.1, U11.6 (A), U13.6 (CANL)
/CAN_TRANSCEIVER_ATA6562/B_to_CANH: R12.1, R60.1, U11.7 (B), U13.7 (CANH)
/CAN_TX_2: U7.3 (B0), U9.1 (TXD)
/DISPLAY_PWR_EN: R68.2, U1.25 (PB12)
/DISPLAY_RS485_DI: U15.2 (Y2), U19.4 (DI)
/DISPLAY_RS485_RO: U15.15 (X2), U19.1 (RO)
/DIS_A: D16.2 (A2), J1.5, L6.2
/DIS_B: D17.2 (A2), J1.6, L9.2
/ECU_A: D13.2 (A2), J1.2, L4.2
/ECU_B: D14.2 (A2), J1.3, L8.2
/FLASH_MEMORY/CS: U1.11 (PA1), U8.1 (~CS)
/FLASH_MEMORY/MISO: U1.16 (PA6), U8.2 (DO(IO1))
/FLASH_MEMORY/MOSI: U1.17 (PA7), U8.5 (DI(IO0))
/FLASH_MEMORY/SCK: U1.15 (PA5), U8.6 (CLK)
/MULTIPLEXER_SWITCH_WAS3157B-6/SEL: U1.38 (PA15), U7.6 (SEL), U14.6 (SEL)
/MULTIPLEXER_SWITCH_WAS3157B-6/SIG1_IN: U1.33 (PA12), U7.4 (A/COM)
/MULTIPLEXER_SWITCH_WAS3157B-6/SIG2_IN: U1.32 (PA11), U14.4 (A/COM)
/MUX_SEL_A: U1.18 (PB0), U15.10 (A)
/MUX_SEL_B: U1.19 (PB1), U15.9 (B)
/RESET: C7.1, J1.15, J3.3, R2.2, SW1.2, U1.7 (NRST)
/RS485_A: D7.2 (A2), J1.17, L3.2
/RS485_B: D8.2 (A2), J1.16, L7.2
/RS485_D1: U5.4 (DI), U15.1 (Y0)
/RS485_DE: R32.2, R58.2, R65.2, U1.27 (PB14), U5.3 (DE), U11.3 (DE), U19.3 (DE)
/RS485_MAX487/A_to_CANL: R62.1, U19.6 (A)
/RS485_MAX487/B_to_CANH: R64.1, U19.7 (B)
/RS485_RO: U5.1 (RO), U15.12 (X0)
/RS485_~RE: R9.1, R31.1, R61.1, U1.2 (PC13), U5.2 (~RE), U11.2 (~RE), U19.2 (~RE)
/RTC_MODULE_IC_PCF8523/RTC_~INT: R16.1, U2.7 (~INT1/CLKOUT)
/SCL: R13.1, U1.42 (PB6), U2.6 (SCL)
/SDA: R14.1, U1.43 (PB7), U2.5 (SDA)
/STM32FC8T6_MCU/3v3_stm: C1.1, C2.1, C3.1, C4.1, C5.1, C6.1, J3.1, JP1.3 (B), JP2.3 (B), L1.2, R2.1, R8.1, R13.2, R14.2, U1.1 (VBAT), U1.9 (VDDA), U1.24 (VDD), U1.36 (VDD), U1.48 (VDD)
/STM32FC8T6_MCU/BOOT0: R3.1, U1.44 (BOOT0)
/STM32FC8T6_MCU/BOOT1: R4.2, U1.20 (PB2)
/STM32FC8T6_MCU/RS485_DI: U1.21 (PB10), U15.3 (Y)
/STM32FC8T6_MCU/RS485_RO: U1.22 (PB11), U15.13 (X)
/STM32FC8T6_MCU/RX1: TP4.1, U1.31 (PA10), U3.54 (UART1_TXD/IO1)
/STM32FC8T6_MCU/TX1: TP3.1, U1.30 (PA9), U3.53 (UART1_RXD/IO0)
/STM32FC8T6_MCU/xtal_1: C11.2, U1.3 (PC14), Y2.2
/STM32FC8T6_MCU/xtal_2: C12.2, U1.4 (PC15), Y2.1
/STM32FC8T6_MCU/xtal_in: C9.2, R7.1, U1.5 (PD0), Y1.3
/STM32FC8T6_MCU/xtal_out: C10.2, R7.2, U1.6 (PD1), Y1.1
/SW0: J1.7, J3.6, U1.39 (PB3)
/ecu_CAN_RX_2: U13.4 (RXD), U14.1 (B1)
/ecu_CAN_TX_2: U7.1 (B1), U13.1 (TXD)
/ecu_RS485_DI: U11.4 (DI), U15.5 (Y1)
/ecu_RS485_RO: U11.1 (RO), U15.14 (X1)
/swdclk: J1.12, J3.4, U1.37 (PA14)
/swdio: J1.8, J3.2, U1.34 (PA13)
GND: AE1.2 (Shield), AE2.2 (Shield), BT1.2 (-), C1.2, C2.2, C3.2, C4.2, C5.2, C6.2, C7.2, C8.2, C9.1, C10.1, C11.1, C12.1, C13.2, C14.2, C15.2, C16.2, C17.2, C18.2, C19.2, C20.2, C21.1, C22.1, C23.2, C24.2, C25.2, C26.2, C27.2, C28.1, C29.2, C30.2, C31.2, C32.2, C33.2, C34.2, C35.2, C36.2, C37.2, C38.2, C39.2, C40.2, C41.2, C42.2, C43.2, C44.2, C46.2, C48.2, C49.2, C50.2, C51.2, C52.2, C53.2, C54.2, C55.2, C56.2, C57.2, C58.2, D3.1 (A1), D4.2 (A), D5.1 (K), D6.1 (K), D7.1 (A1), D8.1 (A1), D9.3 (A), D13.1 (A1), D14.1 (A1), D15.3 (A), D16.1 (A1), D17.1 (A1), D18.3 (A), FL1.2, FL1.3, FL1.5, J1.9, J1.10, J1.11, J2.C5 (GND), J2.MP1, J3.5, J7.6 (VSS), J7.9 (SHIELD), JP1.1 (A), JP2.1 (A), Q3.2 (S), Q5.2 (S), Q6.2 (S), R1.2, R6.2, R18.2, R21.1, R25.1, R32.1, R34.1, R43.2, R44.2, R58.1, R59.2, R60.2, R65.1, R67.2, R69.2, R71.2, SW1.1, U1.8 (VSSA), U1.23 (VSS), U1.35 (VSS), U1.47 (VSS), U2.4 (VSS), U2.9 (VSS), U3.10 (GND), U3.27 (GND), U3.29 (GND), U3.44 (GND), U3.46 (GND), U3.55 (GND), U3.56 (GND), U5.5 (GND), U7.2 (GND), U8.4 (GND), U9.2 (GND), U11.5 (GND), U13.2 (GND), U14.2 (GND), U15.6 (ENABLE), U15.8 (GND), U16.2 (GND), U17.1 (GND), U19.5 (GND), Y1.2, Y1.4
unnamed: AE1.1 (A), FL1.1, R17.2
unnamed: AE2.1 (A), C22.2, D3.2 (A2), R51.2
unnamed: BT1.1 (+), U2.3 (VBAT)
unnamed: D1.2 (A), Q1.1 (G), R1.1
unnamed: D1.1 (K), Q1.2 (S), TH1.2, TP1.1
unnamed: D2.2 (A), R8.2
unnamed: D2.1 (K), U1.26 (PB13)
unnamed: D5.2 (A), R35.2
unnamed: D6.2 (A), R36.2
unnamed: D9.1 (K), L3.1, R37.2, R38.2
unnamed: D9.2 (K), L7.1, R38.1, R39.2
unnamed: D10.1 (K), D11.2 (A)
unnamed: D11.1 (K), D12.2 (A)
unnamed: D15.1 (K), L4.1, R10.2, R11.2
unnamed: D15.2 (K), L8.1, R11.1, R12.2
unnamed: D18.1 (K), L6.1, R62.2, R63.2
unnamed: D18.2 (K), L9.1, R63.1, R64.2
unnamed: D19.2 (A), R18.1
unnamed: J1.4, Q2.3 (D)
unnamed: D4.4 (K), J2.C3 (CLK), R29.2
unnamed: D4.5 (K), J2.C7 (I/O), R30.2
unnamed: D4.3 (K), J2.C2 (RST), R28.2
unnamed: JP1.2 (C), R3.2
unnamed: JP2.2 (C), R4.1
unnamed: L2.1, R17.1
unnamed: Q2.1 (G), R66.2
unnamed: Q3.3 (D), R5.2, R66.1
unnamed: Q3.1 (G), R68.1, R69.1
unnamed: Q5.3 (D), U3.18 (RESET)
unnamed: Q5.1 (G), R20.2, R21.2
unnamed: Q6.3 (D), R22.1, R23.2, U3.9 (PWR_KEY)
unnamed: Q6.1 (G), R24.2, R25.2
unnamed: TP7.1, U1.14 (PA4)
unnamed: TP8.1, U1.46 (PB9)
unnamed: U2.1 (OSCI), Y3.2
unnamed: U2.2 (OSCO), Y3.1
unnamed: C13.1, R15.1, U2.8 (VDD)
unnamed: R33.1, R34.2, U3.15 (ADC0)
unnamed: FL1.4, U3.28 (GPS_RF)
unnamed: C21.2, R51.1, U3.45 (GSM_RF)
unnamed: HST_TXD1.1, U3.38 (HST_RXD)
unnamed: HST_RXD1.1, U3.37 (HST_TXD)
unnamed: R26.1, U3.1 (I2C2_SCL/IO19)
unnamed: R27.1, U3.2 (I2C2_SDA/IO20)
unnamed: D-1.1, U3.35 (USB_N)
unnamed: D+1.1, U3.36 (USB_P)
unnamed: U3.17 (VUSB_DET), USB_VBUS1.1
unnamed: C47.2, R70.2, R71.1, U16.5 (FB)
unnamed: L5.1, U16.3 (LX)
VIN: J1.1, J1.18, TH1.1
