R-Mutura/BIM_BOARD/ASSETS/BIM_PCB_V2/BIM_V2.brd

## EAGLE design ASSETS/BIM_PCB_V2/BIM_V2.brd (2023-12-06)

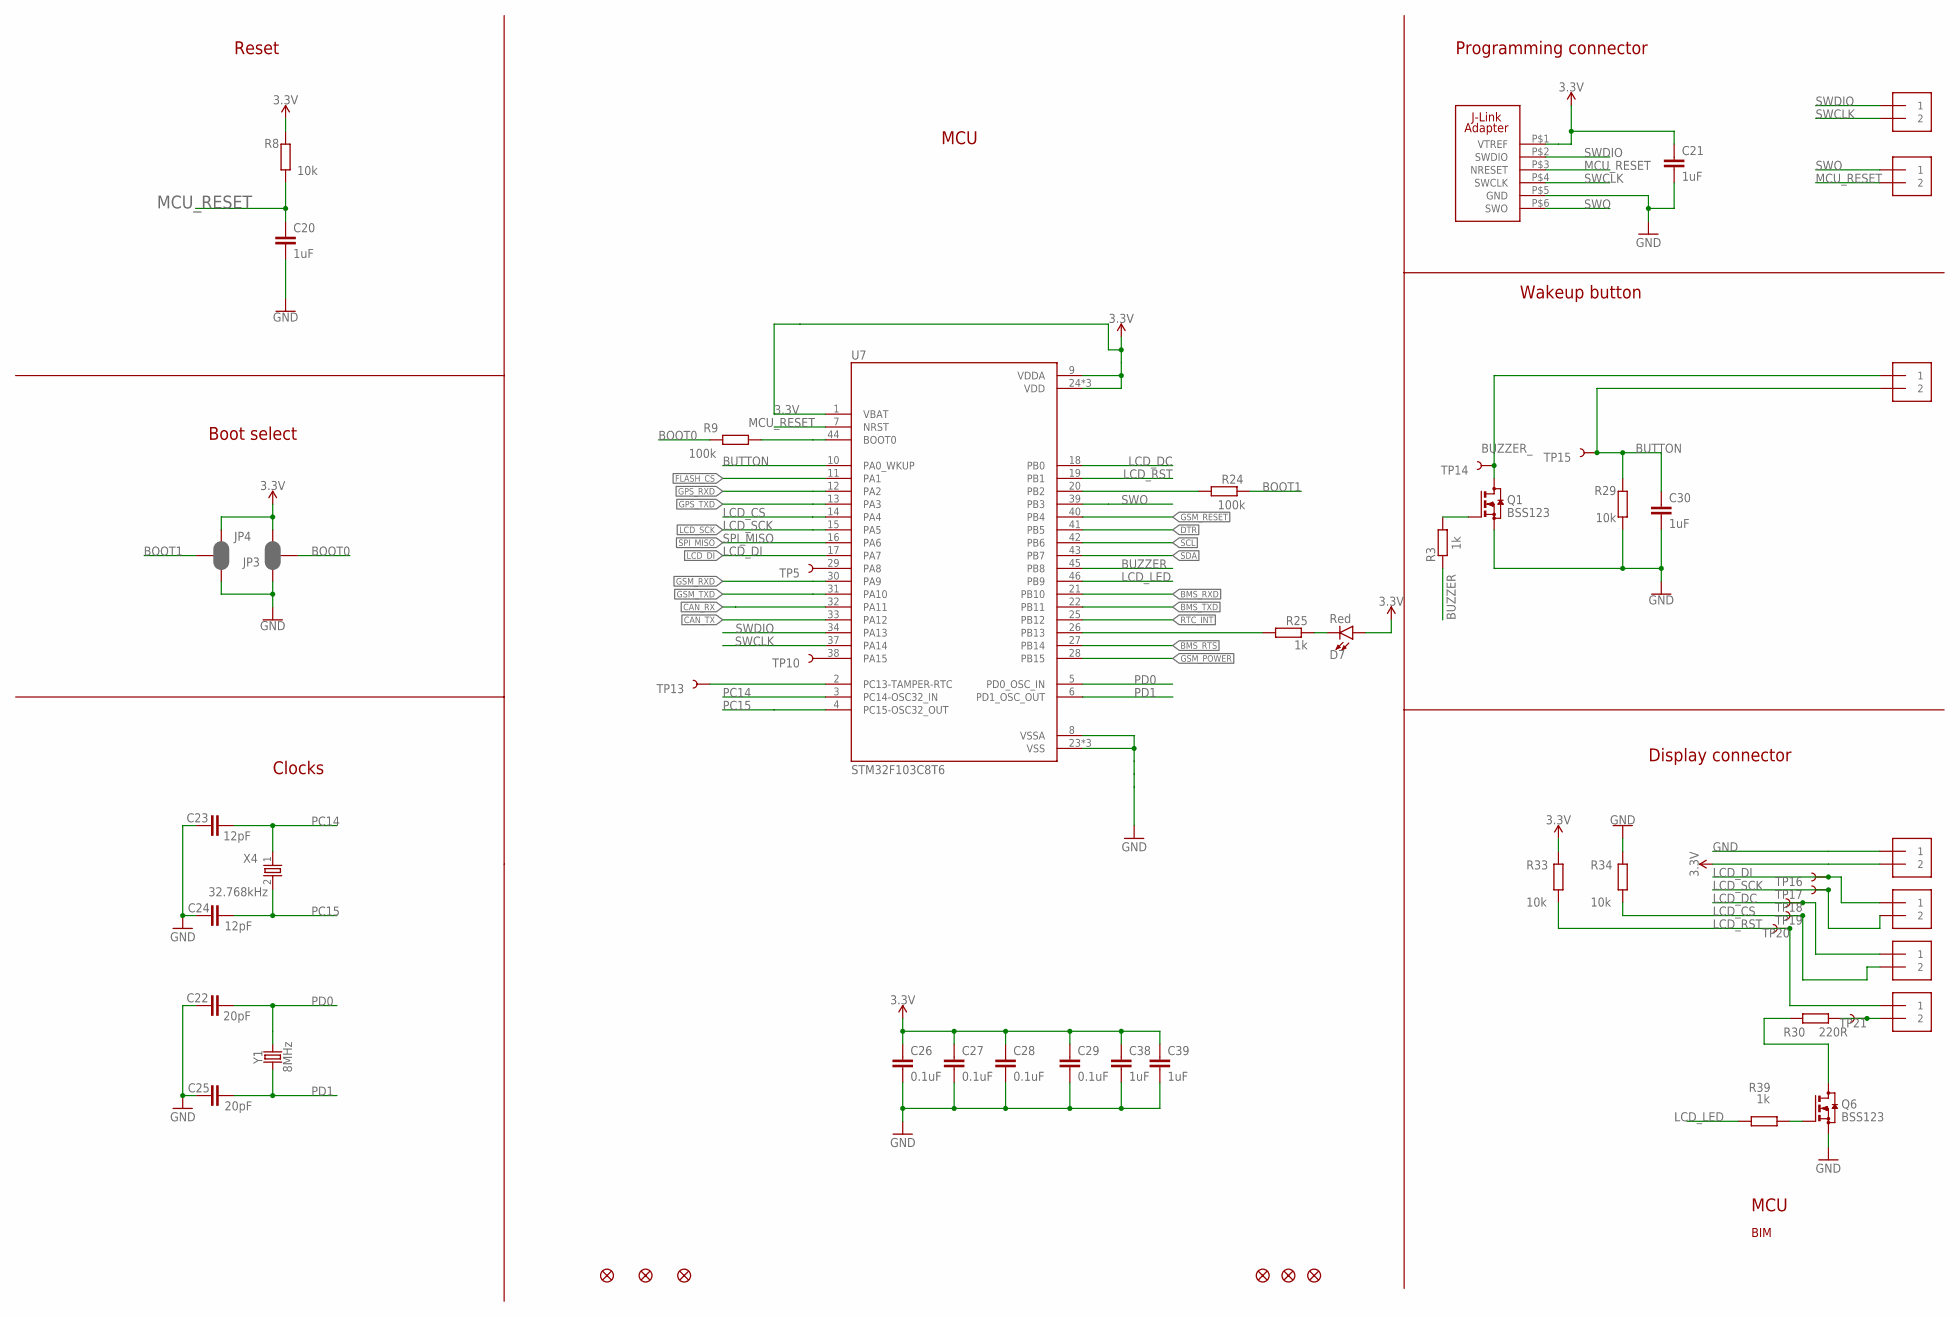
[picture p23: schematic BIM_V2.sch, sheet 1]

Parts:
C20, C21, C30, C38, C39: 1uF; C0402
C22, C25: 20pF; C0402
C23, C24: 12pF; C0402
C26, C27, C28, C29: 0.1uF; C0402
D7: Red; LED-0603
FD1, FD2, FD3, FD4, FD5, FD6: FIDUCIAL1X2; FIDUCIAL-1X2
JP3, JP4: JUMPER-SMT_3_2-NC_PASTE_SILK; SMT-JUMPER_3_2-NC_PASTE_SILK
Q1, Q6: BSS123; SOT23
R3, R25, R39: 1k; R0402
R8, R29, R33, R34: 10k; R0402
R9, R24: 100k; R0402
R30: 220R; R0402
S2, S3, S4: 1X2-3.5MM
TP5, TP10, TP13, TP14, TP15, TP16, TP17, TP18, TP19, TP20, TP21: TEST-POINT3X4; PAD.03X.04
U7: STM32F103C8T6; QFP50P900X900X160-48N
U$1: J-LINK_6-PIN_ADAPTER-1; J-LINK_6-PIN_ADAPTER_S
X3-1, X3-2, X3-3, X3-4: 1X2-3.5MM
X4: 32.768kHz; XTAL_3215_N
Y1: 8MHz; CRYSTAL-SMD-5X3.2-4PAD

Connections:
3.3V: C21.1, C26.1, C27.1, C28.1, C29.1, C38.1, C39.1, D7.A, JP3.3, JP4.3, R8.2, R33.1, U7.1 (VBAT), U7.9 (VDDA), U7.24 (VDD), U7.36 (VDD), U7.48 (VDD), U$1.P$1 (VTREF), X3-1.2; also elsewhere on the board
BMS_RTS: U7.27 (PB14); also elsewhere on the board
BMS_RXD: U7.21 (PB10); also elsewhere on the board
BMS_TXD: U7.22 (PB11); also elsewhere on the board
BOOT0: JP3.2, R9.2
BOOT1: JP4.2, R24.2
BUTTON: C30.1, R29.2, S2.2, TP15.P$1, U7.10 (PA0_WKUP)
BUZZER: R3.2, U7.45 (PB8)
BUZZER_: Q1.3 (D), S2.1, TP14.P$1
CAN_RX: U7.32 (PA11); also elsewhere on the board
CAN_TX: U7.33 (PA12); also elsewhere on the board
DTR: U7.41 (PB5); also elsewhere on the board
FLASH_CS: U7.11 (PA1); also elsewhere on the board
GND: C20.2, C21.2, C22.1, C23.1, C24.1, C25.1, C26.2, C27.2, C28.2, C29.2, C30.2, C38.2, C39.2, JP3.1, JP4.1, Q1.2 (S), Q6.2 (S), R29.1, R34.1, U7.8 (VSSA), U7.23 (VSS), U7.35 (VSS), U7.47 (VSS), U$1.P$5 (GND), X3-1.1; also elsewhere on the board
GPS_RXD: U7.12 (PA2); also elsewhere on the board
GPS_TXD: U7.13 (PA3); also elsewhere on the board
GSM_POWER: U7.28 (PB15); also elsewhere on the board
GSM_RESET: U7.40 (PB4); also elsewhere on the board
GSM_RXD: U7.30 (PA9); also elsewhere on the board
GSM_TXD: U7.31 (PA10); also elsewhere on the board
LCD_CS: R34.2, TP19.P$1, U7.14 (PA4), X3-3.2
LCD_DC: TP18.P$1, U7.18 (PB0), X3-3.1
LCD_DI: TP16.P$1, U7.17 (PA7), X3-2.1; also elsewhere on the board
LCD_LED: R39.2, U7.46 (PB9)
LCD_RST: R33.2, TP20.P$1, U7.19 (PB1), X3-4.1
LCD_SCK: TP17.P$1, U7.15 (PA5), X3-2.2; also elsewhere on the board
MCU_RESET: C20.1, R8.1, S4.2, U7.7 (NRST), U$1.P$3 (NRESET)
unnamed: TP5.P$1, U7.29 (PA8)
unnamed: Q1.1 (G), R3.1
unnamed: TP13.P$1, U7.2 (PC13-TAMPER-RTC)
unnamed: TP10.P$1, U7.38 (PA15)
unnamed: D7.C, R25.1
unnamed: R25.2, U7.26 (PB13)
unnamed: R9.1, U7.44 (BOOT0)
unnamed: R24.1, U7.20 (PB2)
unnamed: Q6.3 (D), R30.2
unnamed: R30.1, TP21.P$1, X3-4.2
unnamed: Q6.1 (G), R39.1
PC14: C23.2, U7.3 (PC14-OSC32_IN), X4.1
PC15: C24.2, U7.4 (PC15-OSC32_OUT), X4.2
PD0: C22.2, U7.5 (PD0_OSC_IN), Y1.3 (2)
PD1: C25.2, U7.6 (PD1_OSC_OUT), Y1.1
RTC_INT: U7.25 (PB12); also elsewhere on the board
SCL: U7.42 (PB6); also elsewhere on the board
SDA: U7.43 (PB7); also elsewhere on the board
SPI_MISO: U7.16 (PA6); also elsewhere on the board
SWCLK: S3.2, U7.37 (PA14), U$1.P$4 (SWCLK)
SWDIO: S3.1, U7.34 (PA13), U$1.P$2 (SWDIO)
SWO: S4.1, U7.39 (PB3), U$1.P$6 (SWO)

Notes on the sheet:
MCU
Reset
Boot select
Clocks
Programming connector
Wakeup button
Display connector
BIM

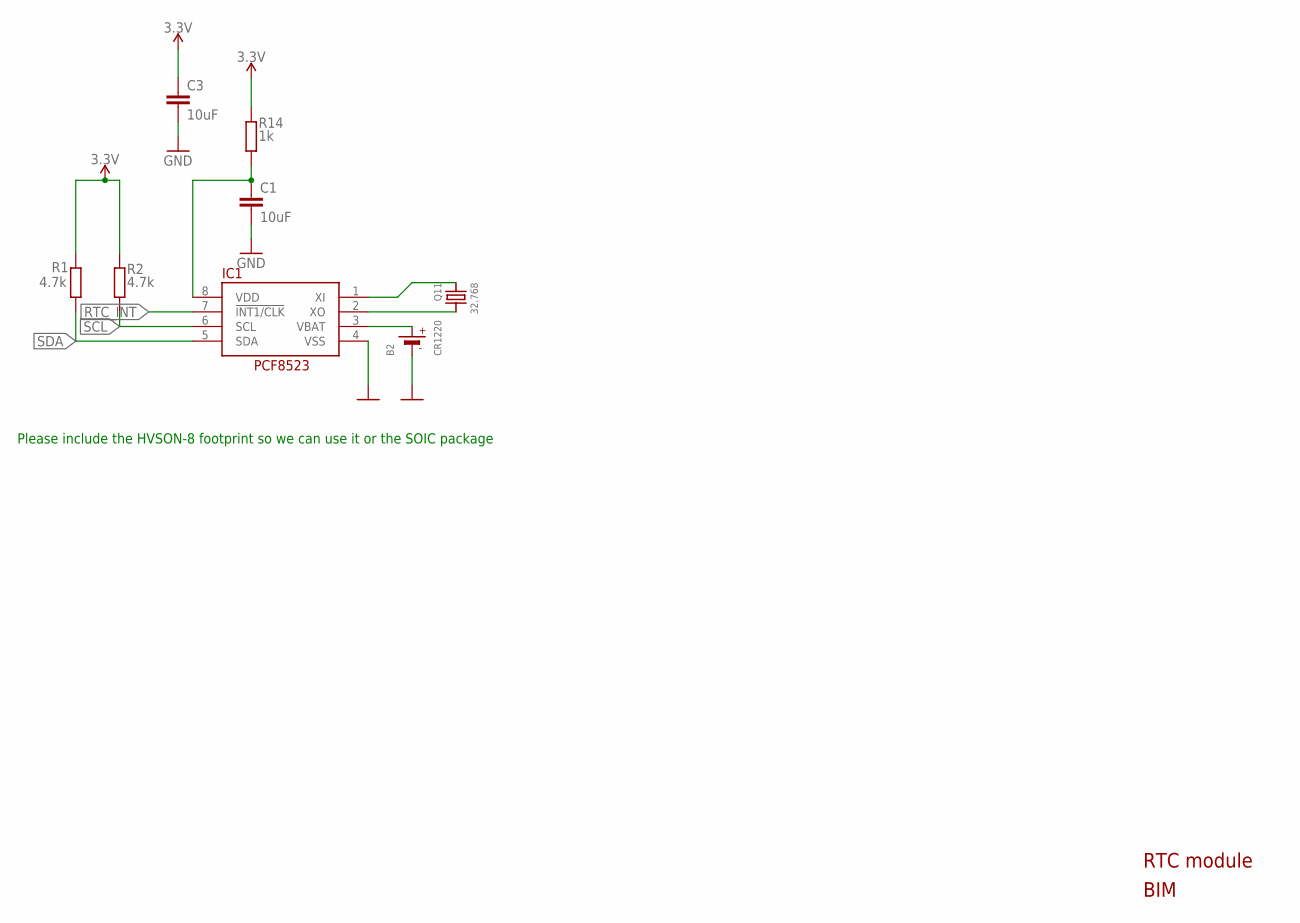
[picture p24: schematic BIM_V2.sch, sheet 2]

Parts:
B2: CR1220
C1, C3: 10uF; C0402
IC1: RTC_PCF8523T; SOIC8_150MIL
Q11: 32.768; CRYSTAL_8X3.8
R1, R2: 4.7k; R0402
R14: 1k; R0402

Connections:
3.3V: C3.1, R1.1, R2.1, R14.1; also elsewhere on the board
GND: B2.-, C1.2, C3.2, IC1.4 (VSS); also elsewhere on the board
unnamed: IC1.1 (XI), Q11.P$1 (1)
unnamed: IC1.2 (XO), Q11.P$4 (2)
unnamed: C1.1, IC1.8 (VDD), R14.2
RTC_INT: IC1.7 (!INT1/CLK); also elsewhere on the board
SCL: IC1.6 (SCL), R2.2; also elsewhere on the board
SDA: IC1.5 (SDA), R1.2; also elsewhere on the board
VBAT1: B2.+$1 (+), IC1.3 (VBAT)

Notes on the sheet:
RTC module
BIM
Please include the HVSON-8 footprint so we can use it or the SOIC package

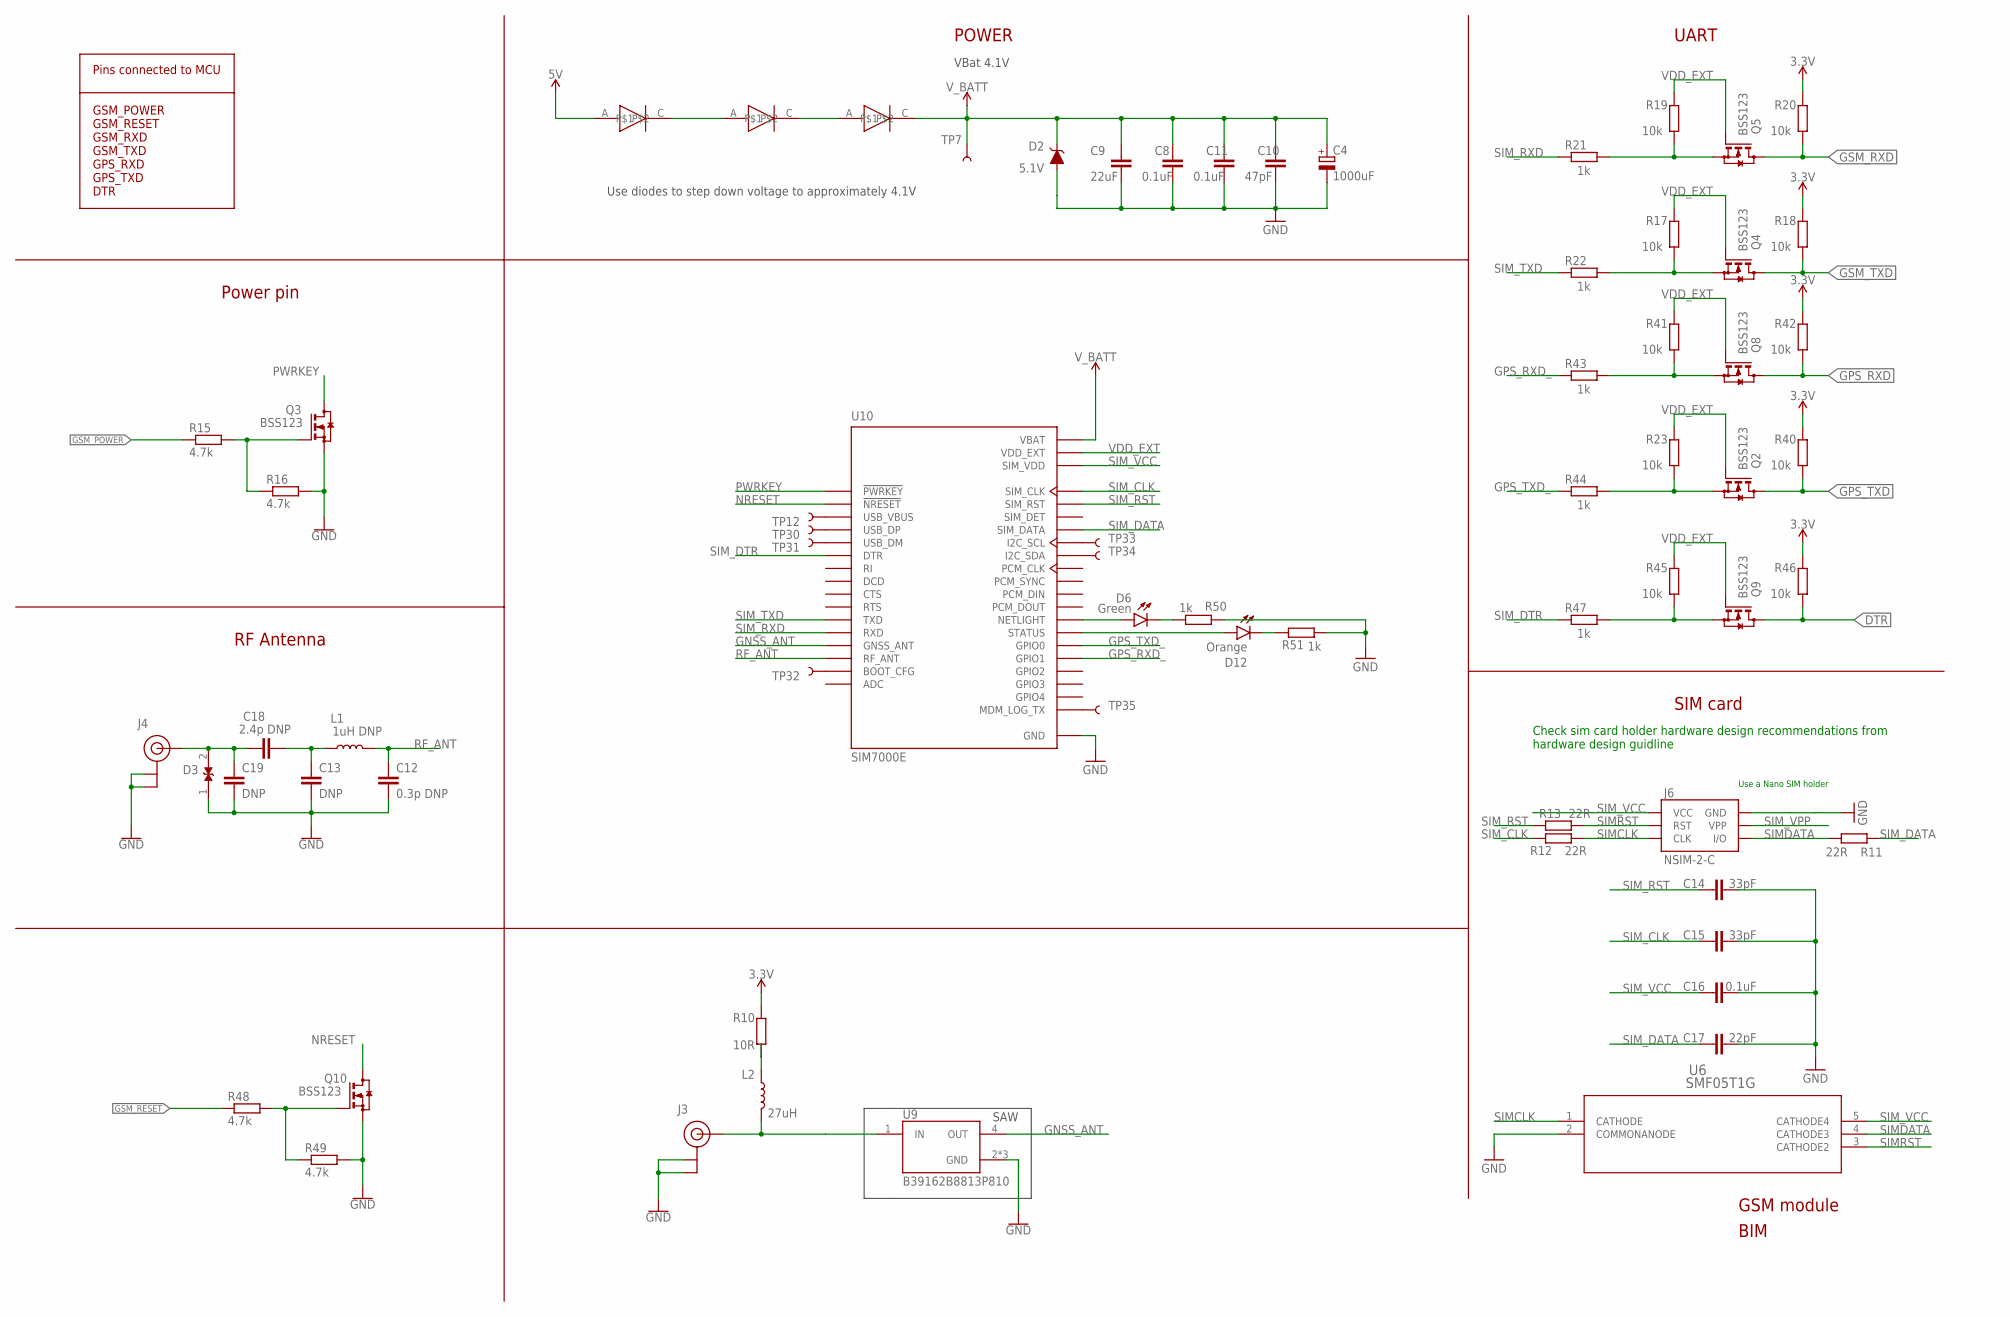
[picture p25: schematic BIM_V2.sch, sheet 3]

Parts:
C4: 1000uF; D/7343-31R
C8, C11, C16: 0.1uF; C0402
C9: 22uF; C0805
C10: 47pF; C0402
C12: 0.3p DNP; C0402
C13, C19: DNP; C0402
C14, C15: 33pF; C0402
C17: 22pF; C0402
C18: 2.4p DNP; C0402
D2: 5.1V; SOD-323
D3: D5V0L1B2LP4-7B; DIODFN100X60X40-2N
D6: Green; LED-0603
D12: Orange; LED-0603
J3, J4: U.FL
J6: NSIM-2-C; SIMHOLDER
L1: 1uH DNP; 0603
L2: 27uH; 0603
Q2, Q3, Q4, Q5, Q8, Q9, Q10: BSS123; SOT23
R10: 10R; R0402
R11, R12, R13: 22R; R0402
R15, R16, R48, R49: 4.7k; R0402
R17, R18, R19, R20, R23, R40, R41, R42, R45, R46: 10k; R0402
R21, R22, R43, R44, R47, R50, R51: 1k; R0402
TP7, TP12, TP30, TP31, TP32, TP33, TP34, TP35: TEST-POINT3X4; PAD.03X.04
U6: SMF05T1G; SC-88A-5_1P35X2P2_ONS
U9: B39162B8813P810; FIL_B39162B9417K610
U10: SIM7000E; SIMCON_SIM7000E
U$2, U$3: 0ohm 2010 resistor; DIOM5436X261N
U$4: HS3FB; DIOM5436X261N

Connections:
3.3V: R10.2, R18.2, R20.2, R40.2, R42.2, R46.2; also elsewhere on the board
5V: U$2.A; also elsewhere on the board
DTR: Q9.3 (D), R46.1; also elsewhere on the board
GND: C4.-, C8.2, C9.2, C10.2, C11.2, C12.2, C13.2, C14.2, C15.2, C16.2, C17.2, C19.2, D2.A, D3.1, J3.1 (GND), J3.2 (GND), J4.1 (GND), J4.2 (GND), J6.C5 (GND), Q3.2 (S), Q10.2 (S), R16.2, R49.2, R50.2, R51.2, U6.2 (COMMONANODE), U9.2 (GND), U9.3 (GND), U9.5 (GND), U10.2 (GND), U10.17 (GND), U10.18 (GND), U10.29 (GND), U10.39 (GND), U10.45 (GND), U10.46 (GND), U10.54 (GND), U10.58 (GND), U10.59 (GND), U10.61 (GND), U10.62 (GND), U10.63 (GND), U10.64 (GND), U10.65 (GND); also elsewhere on the board
GNSS_ANT: U9.4 (OUT), U10.53 (GNSS_ANT)
GPS_RXD: Q8.3 (D), R42.1; also elsewhere on the board
GPS_RXD_: R43.2, U10.49 (GPIO1)
GPS_TXD: Q2.3 (D), R40.1; also elsewhere on the board
GPS_TXD_: R44.2, U10.50 (GPIO0)
GSM_POWER: R15.1; also elsewhere on the board
GSM_RESET: R48.1; also elsewhere on the board
GSM_RXD: Q5.3 (D), R20.1; also elsewhere on the board
GSM_TXD: Q4.3 (D), R18.1; also elsewhere on the board
unnamed: Q10.1 (G), R48.2, R49.1
unnamed: Q3.1 (G), R15.2, R16.1
unnamed: U$3.C, U$4.A
unnamed: U$2.C, U$3.A
unnamed: C13.1, C18.2, L1.1
unnamed: J3.FEED (SIGNAL), L2.2, U9.1 (IN)
unnamed: TP33.P$1, U10.38 (I2C_SCL)
unnamed: L2.1, R10.1
unnamed: TP12.P$1, U10.24 (USB_VBUS)
unnamed: TP30.P$1, U10.27 (USB_DP)
unnamed: TP31.P$1, U10.28 (USB_DM)
unnamed: TP34.P$1, U10.37 (I2C_SDA)
unnamed: D6.C, R50.1
unnamed: D6.A, U10.52 (NETLIGHT)
unnamed: D12.C, R51.1
unnamed: D12.A, U10.66 (STATUS)
unnamed: TP32.P$1, U10.6 (BOOT_CFG)
unnamed: TP35.P$1, U10.23 (MDM_LOG_TX)
NRESET: Q10.3 (D), U10.16 (!NRESET)
PWRKEY: Q3.3 (D), U10.1 (!PWRKEY)
RF_ANT: C12.1, C18.1, C19.1, D3.2, J4.FEED (SIGNAL), L1.2, U10.60 (RF_ANT)
SIMCLK: J6.C3 (CLK), R12.2, U6.1 (CATHODE)
SIMDATA: J6.C7 (I/O), R11.2, U6.4 (CATHODE3)
SIMRST: J6.C2 (RST), R13.2, U6.3 (CATHODE2)
SIMRXD: Q5.2 (S), R19.1, R21.1
SIMRXD1: Q8.2 (S), R41.1, R43.1
SIMTXD: Q4.2 (S), R17.1, R22.1
SIMTXD1: Q2.2 (S), R23.1, R44.1
SIMTXD2: Q9.2 (S), R45.1, R47.1
SIM_CLK: C15.1, R12.1, U10.32 (SIM_CLK)
SIM_DATA: C17.1, R11.1, U10.31 (SIM_DATA)
SIM_DTR: R47.2, U10.3 (DTR)
SIM_RST: C14.1, R13.1, U10.33 (SIM_RST)
SIM_RXD: R21.2, U10.10 (RXD)
SIM_TXD: R22.2, U10.9 (TXD)
SIM_VCC: C16.1, J6.C1 (VCC), U6.5 (CATHODE4), U10.30 (SIM_VDD)
SIM_VPP: J6.C6 (VPP)
VDD_EXT: Q2.1 (G), Q4.1 (G), Q5.1 (G), Q8.1 (G), Q9.1 (G), R17.2, R19.2, R23.2, R41.2, R45.2, U10.15 (VDD_EXT)
V_BATT: C4.+, C8.1, C9.1, C10.1, C11.1, D2.C, TP7.P$1, U10.55 (VBAT), U10.56 (VBAT), U10.57 (VBAT), U$4.C

Notes on the sheet:
GSM module
VBat 4.1V
Check sim card holder hardware design recommendations from hardware design guidline
Pins connected to MCU GSM_POWER GSM_RESET GSM_RXD GSM_TXD GPS_RXD GPS_TXD DTR
UART
SIM card
POWER
Use diodes to step down voltage to approximately 4.1V
RF Antenna
Power pin
BIM
SAW
Use a Nano SIM holder

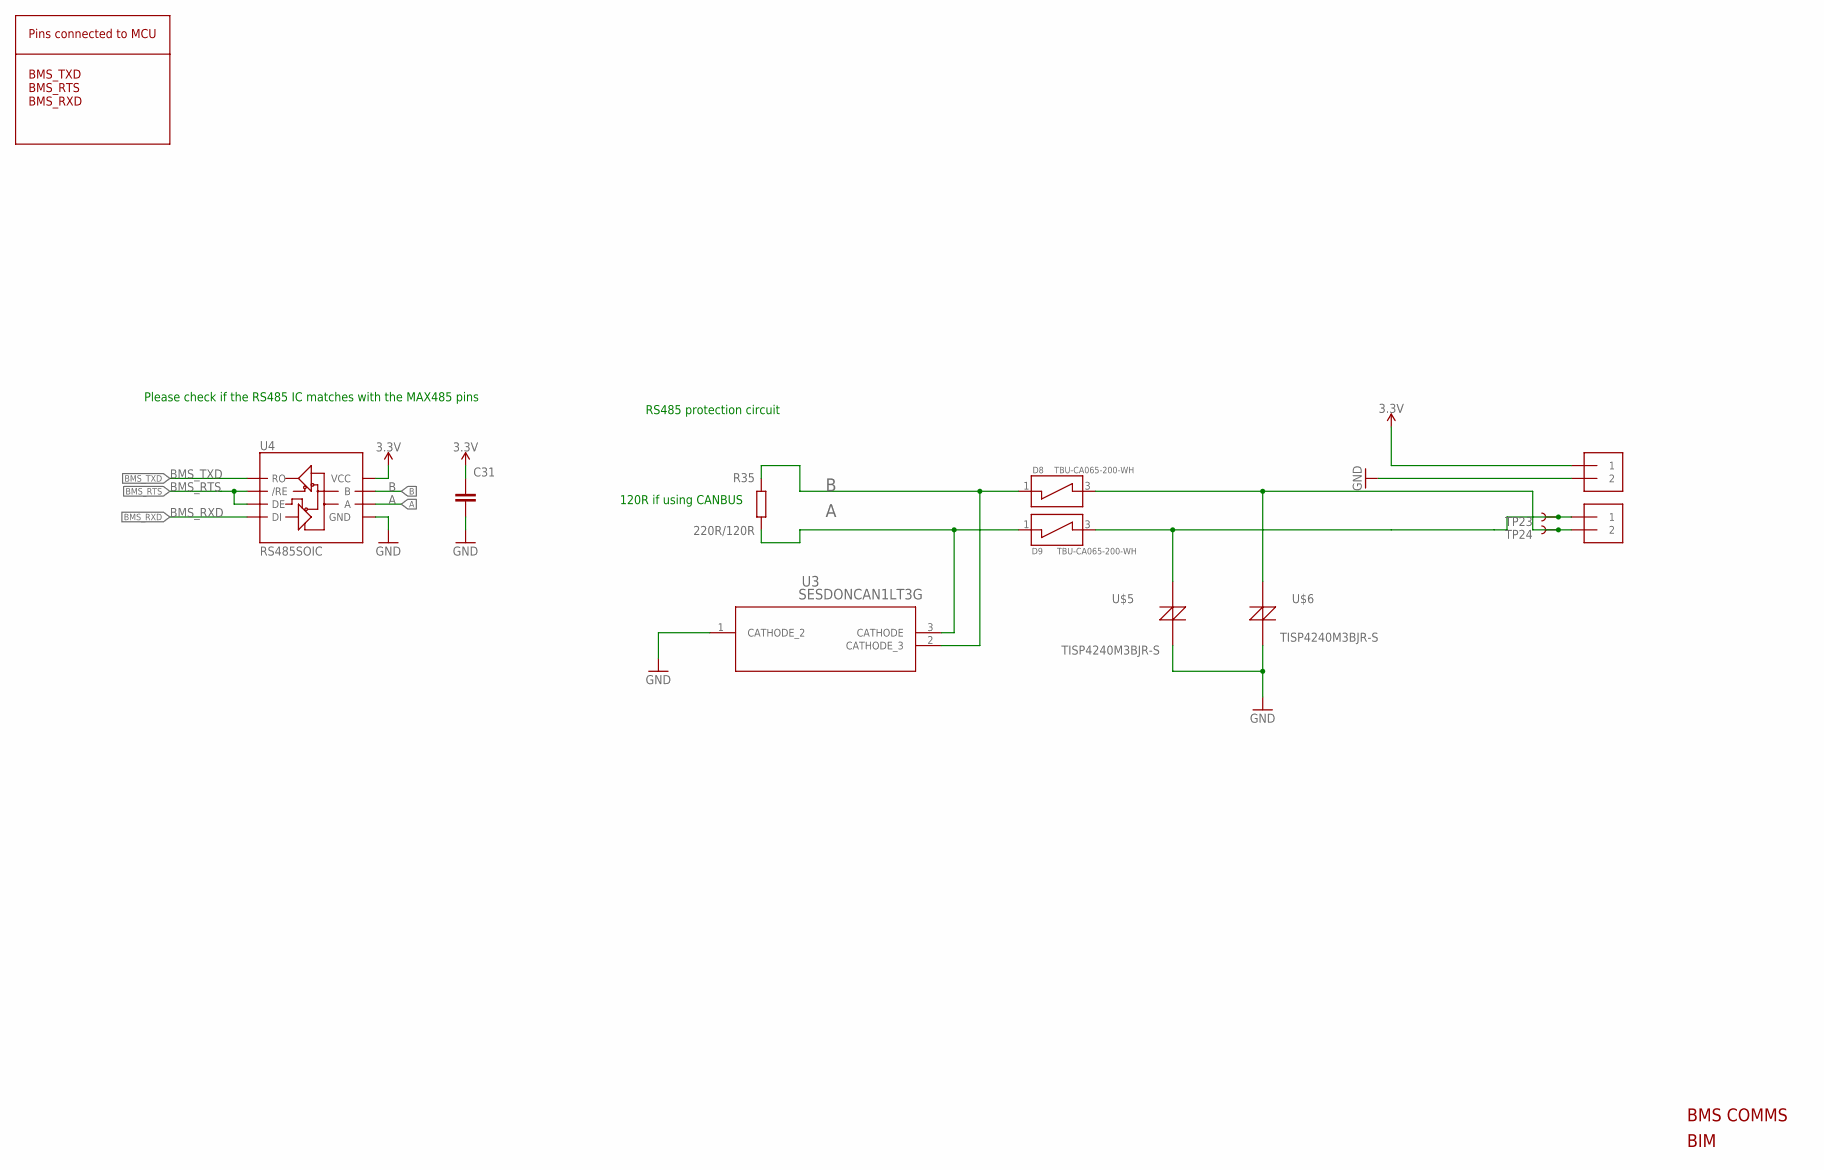
[picture p26: schematic BIM_V2.sch, sheet 4]

Parts:
C31: 0.1uF; C0402
D8, D9: TBU-CA065-200-WH; DIOC650X400X100N
R35: 220R/120R; R0402
TP23, TP24: TEST-POINT3X4; PAD.03X.04
U3: SESDONCAN1LT3G; SOT-23_ONS
U4: RS485SOIC; SO08
U$5, U$6: TISP4240M3BJR-S; DO-214AA
X1-1, X1-2: 1X2-3.5MM

Connections:
3.3V: C31.1, U4.8 (VCC), X1-1.1; also elsewhere on the board
A: D9.1, R35.1, U3.3 (CATHODE), U4.6 (A); also elsewhere on the board
B: D8.1, R35.2, U3.2 (CATHODE_3), U4.7 (B); also elsewhere on the board
BMS_RTS: U4.2 (/RE), U4.3 (DE); also elsewhere on the board
BMS_RXD: U4.4 (DI); also elsewhere on the board
BMS_TXD: U4.1 (RO); also elsewhere on the board
GND: C31.2, U3.1 (CATHODE_2), U4.5 (GND), U$5.1, U$6.1, X1-1.2; also elsewhere on the board
unnamed: D9.3, TP23.P$1, U$5.2, X1-2.1
unnamed: D8.3, TP24.P$1, U$6.2, X1-2.2

Notes on the sheet:
BMS COMMS
Pins connected to MCU BMS_TXD BMS_RTS BMS_RXD
Please check if the RS485 IC matches with the MAX485 pins
RS485 protection circuit
BIM
120R if using CANBUS

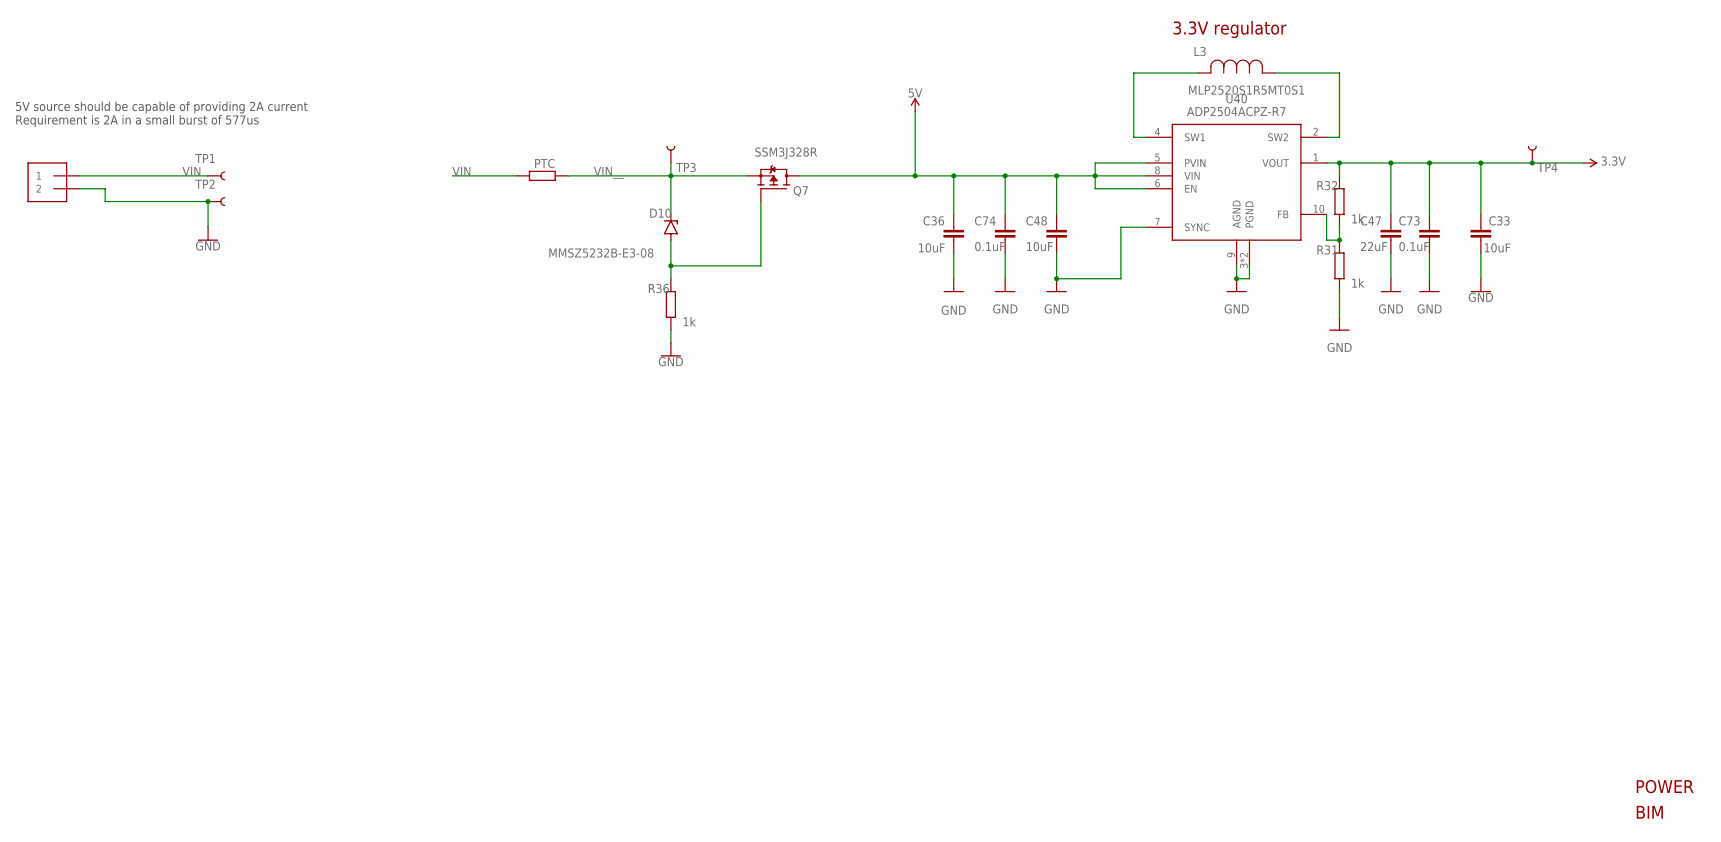
[picture p27: schematic BIM_V2.sch, sheet 5]

Parts:
C33, C36: 10uF; C0603
C47: 22uF; C0603
C48: 10uF; C0402
C73, C74: 0.1uF; C0402
D10: MMSZ5232B-E3-08; SOD80C
L3: MLP2520S1R5MT0S1; IND_2520_TDK
PTC: PRG18BC1R0MM1RB; R0603
Q7: SSM3J328R; SOT-23F
R31, R32, R36: 1k; R0402
TP1, TP2, TP3, TP4: TEST-POINT3X4; PAD.03X.04
U40: ADP2504ACPZ-R7; SON50P300X300X80-11N
X2: 1X2-3.5MM

Connections:
3.3V: C33.1, C47.1, C73.1, R32.1, TP4.P$1, U40.1 (VOUT); also elsewhere on the board
5V: C36.1, C48.1, C74.1, Q7.3 (D), U40.5 (PVIN), U40.6 (EN), U40.8 (VIN); also elsewhere on the board
GND: C33.2, C36.2, C47.2, C48.2, C73.2, C74.2, R31.2, R36.2, TP2.P$1, U40.3 (PGND), U40.7 (SYNC), U40.9 (AGND), U40.11 (PGND), X2.2; also elsewhere on the board
unnamed: R31.1, R32.2, U40.10 (FB)
unnamed: D10.A, Q7.1 (G), R36.1
unnamed: L3.2, U40.4 (SW1)
unnamed: L3.1, U40.2 (SW2)
VIN: PTC.2, TP1.P$1, X2.1
VIN__: D10.C, PTC.1, Q7.2 (S), TP3.P$1

Notes on the sheet:
POWER
5V source should be capable of providing 2A current Requirement is 2A in a small burst of 577us
BIM
3.3V regulator

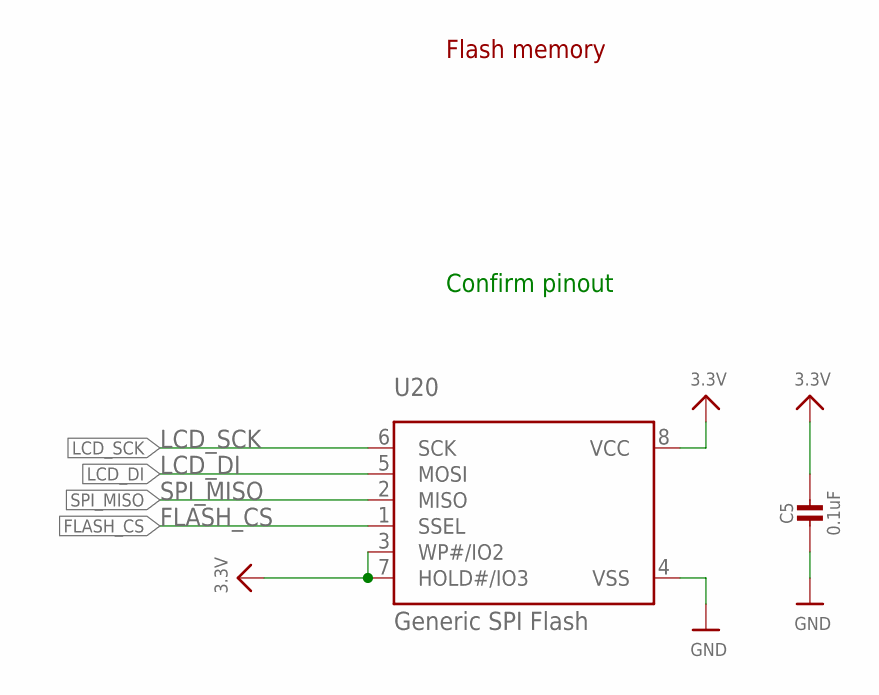
[picture p28: schematic BIM_V2.sch, sheet 6]

Parts:
C5: 0.1uF; 0603-NO
U20: Generic SPI Flash; SOIC8_208MIL

Connections:
3.3V: C5.1, U20.3 (WP#/IO2), U20.7 (HOLD#/IO3), U20.8 (VCC); also elsewhere on the board
FLASH_CS: U20.1 (SSEL); also elsewhere on the board
GND: C5.2, U20.4 (VSS); also elsewhere on the board
LCD_DI: U20.5 (MOSI); also elsewhere on the board
LCD_SCK: U20.6 (SCK); also elsewhere on the board
SPI_MISO: U20.2 (MISO); also elsewhere on the board

Notes on the sheet:
Flash memory
Confirm pinout

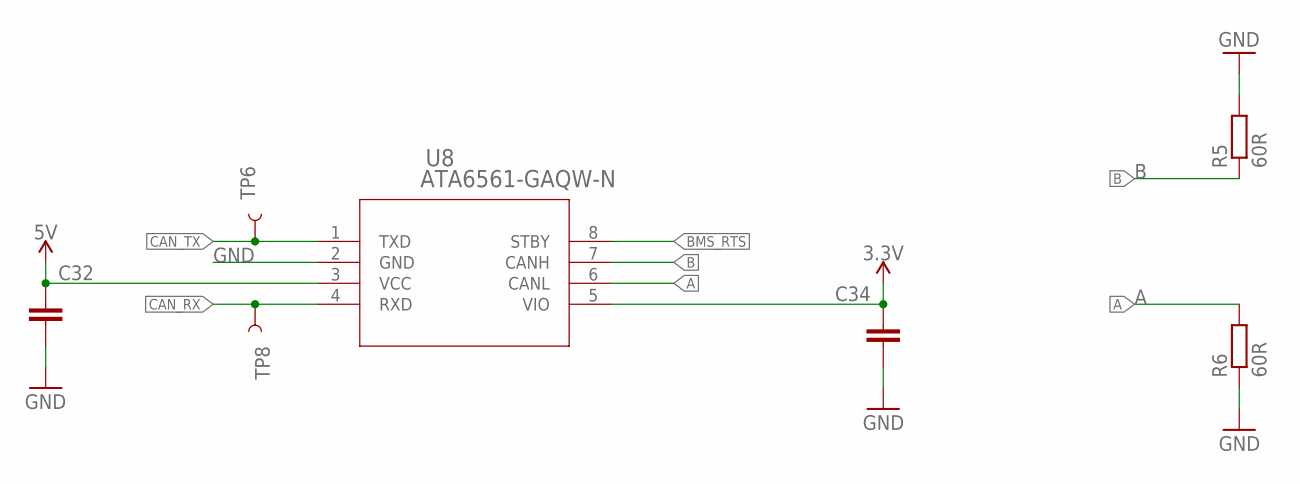
[picture p29: schematic BIM_V2.sch, sheet 7]

Parts:
C32, C34: 0.1uF; C0402
R5, R6: 60R; R0402
TP6, TP8: TEST-POINT3X4; PAD.03X.04
U8: ATA6561-GAQW-N; SOIC8_4P9X3P9MC_MCH

Connections:
3.3V: C34.1, U8.5 (VIO); also elsewhere on the board
5V: C32.1, U8.3 (VCC); also elsewhere on the board
A: R6.2, U8.6 (CANL); also elsewhere on the board
B: R5.1, U8.7 (CANH); also elsewhere on the board
BMS_RTS: U8.8 (STBY); also elsewhere on the board
CAN_RX: U8.4 (RXD); also elsewhere on the board
CAN_TX: U8.1 (TXD); also elsewhere on the board
GND: C32.2, C34.2, R5.2, R6.1, U8.2 (GND); also elsewhere on the board

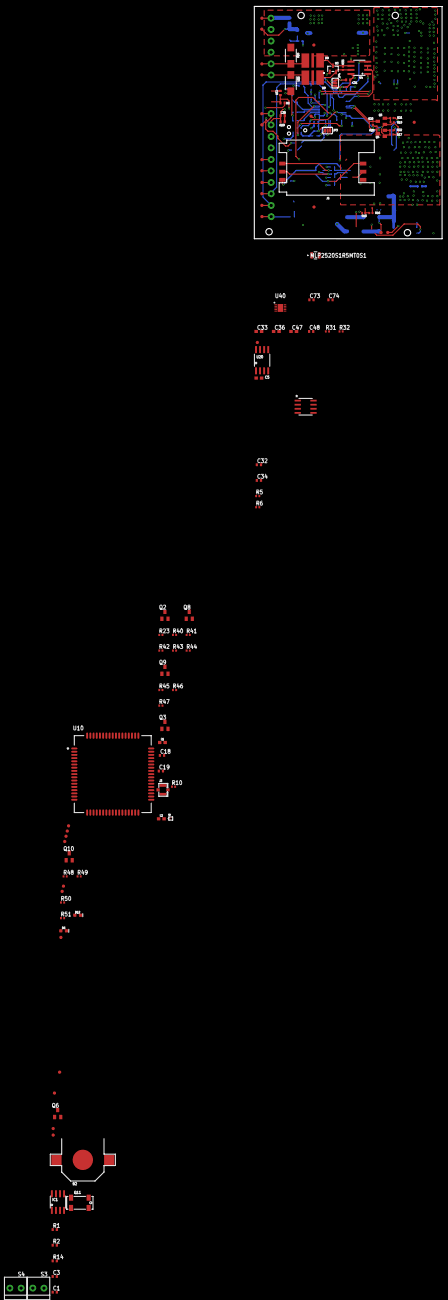
[picture p30: board BIM_V2.brd from above]

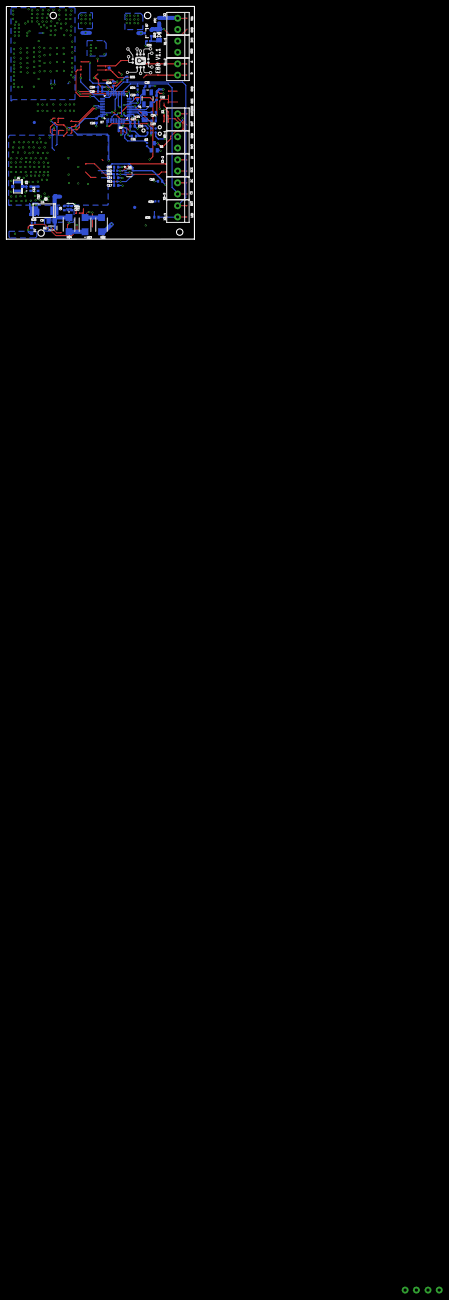
[picture p31: board BIM_V2.brd from below]

Board: 4 copper layers, 58.6 x 72.5 mm, 172 parts (61 on the bottom side), 105 nets.
