R-Mutura/BIM_BOARD/(commit log)

2023-12-07 updates on schematic and complete layout
    [BIM_PCB.kicad_pcb, BIM_PCB.kicad_sch, BIM_V2.DXF, CAN_TRANSCEIVER_ATA6561.kicad_sch, MOSFET_LOGIC_LEVEL_TRANSLATOR.kicad_sch, RS485_MAX485.kicad_sch, STMFC8T6_MCU.kicad_sch]
2023-12-10 completed design PCN and Images
    [BIM_PCB.csv, BIM_PCB.kicad_pcb, BIM_PCB.kicad_sch, CAN_TRANSCEIVER_ATA6561.kicad_sch, MOSFET_LOGIC_LEVEL_TRANSLATOR.kicad_sch, MULTIPLEXER_SWITCH_WAS3157B-6.kicad_sch, RS485_MAX485.kicad_sch, SIM7000_GPRS_MODULE.kicad_sch]
2023-12-11 complete BIM Board
    [BIM_PCB-B_Cu.gbr, BIM_PCB-B_Mask.gbr, BIM_PCB-B_Paste.gbr, BIM_PCB-B_Silkscreen.gbr, BIM_PCB-Edge_Cuts.gbr, BIM_PCB-F_Cu.gbr, BIM_PCB-F_Mask.gbr, BIM_PCB-F_Paste.gbr]
2023-12-12 updates on the buck 3v3 supply
    [BIM_PCB-B_Cu.gbr, BIM_PCB-B_Mask.gbr, BIM_PCB-B_Paste.gbr, BIM_PCB-B_Silkscreen.gbr, BIM_PCB-Edge_Cuts.gbr, BIM_PCB-F_Cu.gbr, BIM_PCB-F_Mask.gbr, BIM_PCB-F_Paste.gbr]
2023-12-12 bom updates
    [BIM_PCB.csv, BIM_PCB.xlsx]
2023-12-17 update to A9G and connector
    [A9G_GSM_GPRS_MODULE.kicad_sch, BIM_PCB.kicad_pcb, BIM_PCB.kicad_sch, MOSFET_LOGIC_LEVEL_TRANSLATOR.kicad_sch, SIM7000_GPRS_MODULE.kicad_sch, STMFC8T6_MCU.kicad_sch, TF_CARD_CONN.kicad_sch]
2023-12-18 updated step
    [A9G_GSM_GPRS_MODULE.kicad_sch, BIM_PCB.kicad_pcb, SY8089_BUCK_CONVERTER.kicad_sch, TF_CARD_CONN.kicad_sch]
2023-12-18 updated GENERAL
    [A9G_GSM_GPRS_MODULE.kicad_sch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]
2024-01-13 completed gerber and placement
    [A9G_GSM_GPRS_MODULE.kicad_sch, BIM_PCB.kicad_sch, RTC_MODULE_IC_PCF8523.kicad_sch, TF_CARD_CONN.kicad_sch]
2024-01-16 updates in BOM gerber and PCL
    [A9G_GSM_GPRS_MODULE.kicad_sch, BIM_PCB.csv, BIM_PCB.kicad_pcb, BIM_PCB.xlsx, BIM_PCB_reference.xlsx]
2024-01-16 completed project
    [A9G_GSM_GPRS_MODULE.kicad_sch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]
2024-01-17 completed BIM board- ECOBoda
    [BIM_PCB-B_Cu.gbr, BIM_PCB-B_Mask.gbr, BIM_PCB-B_Paste.gbr, BIM_PCB-B_Silkscreen.gbr, BIM_PCB-Edge_Cuts.gbr, BIM_PCB-F_Cu.gbr, BIM_PCB-F_Mask.gbr, BIM_PCB-F_Paste.gbr]
2024-01-23 completed project and all the prouction files
    [A9G_GSM_GPRS_MODULE.kicad_sch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]
2024-01-28 all items updated
    [A9G_GSM_GPRS_MODULE.kicad_sch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]
2024-01-28 all items updated including fiducial
    [BIM_PCB-B_Cu.gbr, BIM_PCB-B_Mask.gbr, BIM_PCB-B_Paste.gbr, BIM_PCB-B_Silkscreen.gbr, BIM_PCB-Edge_Cuts.gbr, BIM_PCB-F_Cu.gbr, BIM_PCB-F_Mask.gbr, BIM_PCB-F_Paste.gbr]
2024-02-07 BIM updated BOM and placement files guide pdf added
    [BIM_PCB.csv, BIM_PCB.kicad_pcb, BIM_PCB.xlsx]
