R-Mutura/BIM_BOARD/(notices)

Notices in the files:
parts and their libraries:
SparkFun-Connectors: Licensing: Creative Commons ShareAlike 4.0 International - https://creativecommons.org/licenses/by-sa/4.0
SMF05T1G: COPYRIGHT: Copyright (C) 2021 Ultra Librarian. All rights reserved.
MLP2520S1R5MT0S1: COPYRIGHT: Copyright (C) 2022 Ultra Librarian. All rights reserved.
